ji1109-shuai/fpgashare/README.md

# FPGA 零件智能视觉定额备料系统

基于安路 PH1P35 FPGA 与 SC500CS 摄像头的工业零件视觉识别和输送控制原型，集成图像采集、成像调节、多目标识别、分类计数、批次配额、输送控制及屏幕交互。

本目录整理自当前整机工程。历史文档中的参数、路径与旧版功能以当前源码及下列最新说明为准。

## 主要功能

- 1280×720 图像采集处理与 HDMI 显示，DDR 帧缓存。
- 自动曝光优先调整曝光时间，配合增益边界补偿；默认亮度目标152±8，连续16个有效测光包达标后锁定，目标可调。
- 自动筛选候选中性像素进行白平衡；样本不足时保持最近有效补偿。
- 原图、灰度、Sobel、边缘、二值及形态学预览；工业增强支持细节强度、噪声门限及原图/增强对照，模式7为ENHN。
- 螺丝、垫圈、六角螺母、四方螺母多目标识别及颜色/形状标签。
- 跨检测批次身份关联与方向越线计数；分类配额完成停机、错料/超额保护、普通异常清除确认与故障ACK。
- 10 kHz PWM输送控制，低/中/高档占空比分别为65%/80%/100%。
- NG状态蜂鸣提示，菜单参数配置，完整输出帧率FPS和识别批次耗时DET显示。

显示增强独立于识别输入。FPS不是HDMI刷新率，DET不是摄像头到屏幕的端到端延迟。照片或单次显示值不能作为长期准确率统计。

## 目录

- td_project/：TD工程入口及项目时序约束。
- user_source/：HDL、IP配置与生成HDL、约束、字体及图标ROM。
- sim/：维护中的功能测试、运行脚本和必要测试输入。
- tools/：构建、交付和核验工具。
- mechanical/：本工程中的参数化机械设计及模型。
- docs/：功能说明、操作记录与历史设计资料。
- HANDOFF.md：工程交接及验证边界。

## 开发环境与入口

- 工程文件：td_project/camera_to_dsi_display.al
- 工具记录：Anlogic TD 6.2.168116
- 器件：PH1P35MDG324，速度等级-3
- 摄像头：SC500CS
- 电机驱动：L298N

保持td_project与user_source同级。工程文件保留原始内容，Project Path仍记录开发电脑的路径；换机时应在TD中确认解压目录并另存工程。部分工具脚本使用本机安装路径，运行前按实际环境调整。

logo_idx.hex、logo_pal.hex、industrial_font16.hex是必要ROM资产。手动建立综合/实现Run时须将其复制至相应运行目录；tools/build_ae_once.ps1保留原资源复制逻辑。

## 操作与验证资料

- [整机功能与控制规则](docs/INDUSTRIAL_UPGRADE_20261102.md)
- [视觉增强与原图对照](docs/VISUAL_ENHANCE_20261102.md)
- [界面叠加调整](docs/UI_OVERLAY_20261102.md)
- [电机档位、恢复与帧率](docs/MOTOR_FPS_20261102.md)
- [异常蜂鸣联动](docs/BATCH_BUZZER_20261103.md)
- [仿真入口与覆盖边界](sim/README.md)

仿真、物理时序分析和上板运行分别验证不同层面。构建报告不能替代现场验证；普通照明宽阴影等历史限制见对应文档。本次GitHub整理只核对文件与工程依赖，未重新生成bit。

## 第三方代码与许可

本工程包含厂商示例、生成IP及加密HDL，保留原版权声明。当前未为整个混合工程指定统一开源许可证，也未对第三方资料授予新的许可。相关范围见[第三方说明](THIRD_PARTY_NOTICES.md)。

## 提交内容

包含当前源码、必要资源、维护中的测试与工具、机械设计及文字资料。未纳入本机TD Runs、历史交付归档、波形、编译缓存和日志；旧分支中已有历史资料保留在其原有位置。
