ji1109-shuai/fpgashare/docs/AE_ONCE_AND_MOTION_20261101.md

# 自动曝光收敛锁定与传送带速度分析（2026-11-01）

> 历史版本：下述曝光操作与旧bit保留用于追溯。用户反馈仍需手调后，已确认默认MAN、运动/目标门控、中心测光和I2C应答存在缺陷。当前源码及本轮交付请看 [开机曝光完整闭环修正](AE_CHAIN_BOOT_20261101.md)。本文速度限制分析仍适用，旧18项测试不能代替新闭环测试。

## 修改范围

本次用户指定的工程是 `D:/fpgashare/fpgashare (4)/fpgashare`，TD 入口为该目录的 `td_project/camera_to_dsi_display.al`。不是根工程，也不是 `fpgashare (3)`。

生产修改仅有 `uiisp_beta/ae_set.v`、`design_top_wrapper.v`、`hdmi_mixer.v`：增加一次性曝光收敛锁定、独立的电机暂停条件、菜单实际状态显示。原识别算法、自动白平衡、安路图标、确认框/标签、Sobel/EDGE、DDR 数据路径及引脚/时序约束保持原逻辑。

## 实际操作

1. 保持传送带停止，先让画面中心 64×64 区域露出正常背景，打开菜单选择 `AE:AUTO`。
2. 沿用原始绿色通道均值和 176～216 的宽死区。偏亮或偏暗连续四个有效观测包方向一致时才调整一次；每次 I2C 写入完成后先丢弃两个观测包，等待曝光生效。
3. 无已发布目标、相机配置完成、无待写参数时，连续八个观测包落在死区内才锁定，菜单显示 `AE:LOCK`。锁定后亮度变化、目标进入或传送带启停都不会再自动修改 EXP/GAIN。
4. 需要适应新的照明时，选择一次 `AE:MAN`，再切回 `AE:AUTO`，显式开始下一次调整。系统复位也清除锁定。手动修改菜单 EXP/GAIN 时沿用原逻辑转为 MAN。
5. 未收敛就启动传送带时显示 `AE:HOLD`，暂停自动调节；停带后可继续未完成的收敛。已经 LOCK 的会话停带后仍为 LOCK。

上电仍为原来的 MAN；不会擅自开始自动曝光。无法达到目标区间、达到 EXP/GAIN 上下限或亮度无效时不宣称 LOCK，不进行重复的相同参数 I2C 写入。亮度小于16仍沿用原逻辑不自动追亮，以免失效/遮挡数据驱动补偿。

这里的亮度是 `awb.v` 诊断包 `[119:112]` 的 AWB 前中心区域绿色均值，不是全图测光、物体测光或新的亮度算法。EXP 是该传感器现有控制码，不能直接当成微秒。自动白平衡没有随 AE 一起冻结；当前灯光/背板的颜色验证结论也不因本次修改而扩大。

## 为什么速度提高后会更难识别

源码与定向功能测试确认了一处明确限制：`img_parts_multi_tracker` 只在相邻**识别批次**的同类目标满足 `dx<=64 && dy<=64`、宽高变化各不超过32像素时继承确认历史；需三次关联观测才输出确认框。`tb_tracker_speed_boundary` 证明64像素/批次仍能确认，65像素/批次连续运动会反复从第一次确认开始。这里不是64像素/摄像头帧，不能在未知批次发布间隔、视野尺寸和实际带速时换算成毫米/秒。

同时，`img_tire.take` 在上一批尚未分析完成时会跳过新的帧头；现有 HDMI 插值只是让框移动平滑，不会提高前端识别频率，也不是速度预测跟踪。

## 帧差的作用与建议

帧差可以作为运动候选/活动区域证据，但不宜单独替换现有形状和颜色识别：对于相邻两帧在相同位置的像素，绝对差检测的是变化。停止或慢移物体的重合部分可能没有差分，移动织纹、阴影、曝光变化也可能产生差分。背景模型差分与相邻帧差分是不同方法；本工程已有的空带参考逻辑也不能直接称为已实现运动帧差。

建议后续结合现有 8×8 粗网格做低资源运动统计，以运动方向/估计速度辅助现有一对一目标关联，再根据稳定 ID 做越线计数；同时量测接受帧间隔、发布间隔和拖影。若要提高吞吐量，还要单独优化形态学/连通域分析和候选扫描。不能通过扩大一个位移门限或减少确认次数就宣称高速检测已可靠，也不能靠帧差恢复曝光造成的运动模糊。

本轮仅完成曝光锁定与速度限制的可复现分析，**未把帧差、速度预测或新的计数逻辑接入生产识别**；没有从另一个工程覆盖迁入算法。

参考资料：OpenCV 官方 `How to Use Background Subtraction Methods`（https://docs.opencv.org/4.x/d1/dc5/tutorial_background_subtraction.html）区分静态相机前景掩膜与背景模型更新；Basler 官方 `Exposure Auto`（https://docs.baslerweb.com/exposure-auto）中的 Once/Continuous 说明可用于理解一次性调节与连续调节的区别，不代表本工程传感器型号或控制寄存器相同。

## 验证与交付

运行新增功能测试：

```powershell
& ./sim/run_ae_once_regression.ps1
```

包括默认与边界参数 AE、I2C 忙期间保持/生效等待、锁定保持/重新触发、手动优先、上下限、无效亮度、两种显示读延迟下 MAN/AUTO/LOCK/HOLD 菜单，以及当前识别器64/65像素关联边界。测试输出位于 `sim/ae_once_20261101_validation`，前次生产源码备份保存在其 `before` 子目录。

既有测试夹具同时进行了必要校正：`tb_screen_menu` 原先假定上电 AUTO，但修改前的 v3 生产代码已经默认 MAN；现按真实默认值验证 MAN→AUTO→MAN→AUTO 和手动编辑退出 AUTO。旧 `tb_batch_counter` 把“短按”设为7周期、长按门限却只有6周期，且在采样上升沿改变输入；现将短/长按分开为7/20周期、门限12周期，并在下降沿驱动、等待同步与消抖完成。生产 `screen_menu_control`、`conveyor_batch_counter`、`l298n_motor_control` 三个模块与本轮开始前逐字一致，没有为测试修改其行为。

历史整组 `tb_parts_multi_no_calibration` 在普通照明/宽软影阶段仍失败（frame22：期望4框，实际0框，候选4）；其依赖的 `img_proj.v` 等识别源码本轮哈希未变。失败日志原样保留在 `sim/ae_once_parts_20261101_validation`。新增 `BACKLIT_ONLY` 仅为测试参数，保留原测试默认行为，另以 `tb_parts_multi_backlit` 和 `tb_parts_multi_backlit_latency` 完整覆盖当前背光场景的四目标、颜色变换、确认、删除换序、溢出、空带/无背板及延迟；不把旧普通照明失败描述为已经修复。

整机重建使用 `tools/build_ae_once.ps1`：从本工程 `.al` 读取源码清单，在新的独立 synthesis/physical 目录运行，记录全部输入哈希，不覆盖已有 bit。

本轮18项定向测试顶层通过（详细逐项结果见 `sim/ae_once_20261101_validation/verification.json`），不包括上述保留失败的历史普通照明整组用例。除新增7项曝光/菜单/关联边界测试外，覆盖 HSV、形状流水线、背光多目标与延迟、动态框、8种完整720p显示模式、Sobel/EDGE各3帧DDR连续性、真实自动白平衡及720p ISP。

TD 于2026-11-01 19:55完成物理与bit生成：

- 原始run：`td_project/camera_to_dsi_display_Runs/phy_ae_once_20261101_193113`。
- 交付bit：`release_archive/ae_once_lock_20261101/camera_to_dsi_display_ae_once_lock.bit`。
- 大小：1,789,539字节。
- SHA256：`E9F5B9AB973342E3CF95AEF5D7488A46CBC7073CE887FC63721373AC2360FD56`。
- Setup WNS `+0.111ns`、Hold WNS `+0.020ns`，Setup/Hold TNS及违例端点均0；STA覆盖94.76%，现有告警和时钟例外保留。
- 最终Slice 19483/21216、LUT6 19008/21216、ERAM 76/108、DSP 20/40；Routing DRC完成且无错误。
- 62项TD输入哈希均与当前源码一致，独立run源清单与当前 `.al` 完全匹配；识别、白平衡、视频模式、SDC及引脚约束6项保护哈希未变。
- 构建记录：`td_project/camera_to_dsi_display_Runs/ae_once_build_20261101_193113.json`。交付目录同时保留时序、资源、时钟例外和完整验证记录。未提交或推送Git。

功能仿真、TD 物理时序与上板实测是三个不同层次；目前没有本次新版的上板结论，不能声称实际可用带速已提高或现场颜色已通过。
