ji1109-shuai/fpgashare/docs/MOTOR_FPS_20261102.md

# 电机自动恢复、三档PWM与实时FPS

唯一工程：`D:/fpgashare/fpgashare (4)/fpgashare`，入口 `td_project/camera_to_dsi_display.al`。本轮只改 `design_top_wrapper.v` 和 `hdmi_mixer.v` 两份生产文件；先前的曝光、白平衡、工业增强、透明UI和安路图标保留。

## 操作与恢复条件

- SW4打开菜单，K1/K2选中MOTOR，K3减档、K4加档；STOP、LOW65%、MID80%、HI100%循环。PWM仍为10kHz，IN1输出PWM，IN2固定低；100%为持续高电平。百分比表示占空比，不等同于实测传送带线速度。
- 普通错件或超额停车时保留用户档位。错误类别连续三次新的完整检测发布均未再出现，才解除NG并按保留档位恢复。没有新检测、一次或两次漏检都不能恢复；该类尚未确认但仍被观测到时也视为在场。其他正确类别可以仍在视野内。
- 配额为0的已确认类别在上游被发现就停车，不必等它过计数线。
- 暂停期间手动选择STOP会取消自动启动；批次DONE和NEW BATCH清场会清除速度，之后保持STOP。
- 检测溢出、身份歧义、重复slot、未知类别、首次从下游出现及计数饱和等故障仍要求ACK；至少三次清除观测且检测fault解除后才能确认。普通错件不需要ACK。
- 移走超额件后，仅将本批接受数量修剪到配额，PASS累计通过数量保留，便于审计。达到全部配额后仍保持完成停车。

## FPS含义与显示

左上角批次状态下一行新增FPS，16×16字体、20像素行距、透明背景、亮暗自适应字色。上电首个统计窗口前显示`---`，随后每秒更新整数帧率，例如`030`。

统计点位于ISP输出、video_in之前。每个1280×720 RGB图像由172800个128位有效字组成，只有收到SOF并累积完整帧字数才产生一次完成事件；以50MHz系统时钟统计一秒窗口。跨域只同步完成翻转事件和每秒保持的BCD数值，HDMI在自身SOF锁存，避免一帧内文字撕裂。无新完整图像的一秒窗口显示000。该数值是ISP完整输出帧率，并不表示检测更新率或DDR实际呈现帧率。

## 功能验证与证据边界

当前17项定向顶层回归通过，见`sim/motor_resume_20261102_validation/verification.json`。覆盖实际STOP/65/80/100周期测量、三档错件移除恢复、三次完整发布、掉检/重新出现、手动STOP、硬故障ACK、DONE与超额审计；450个完整帧、非完整帧不计、异步时钟、十进制进位、统计窗口边界和停摄归零；FPS的SOF更新与中途保持。

UI两种DDR读延迟各十个720p画面，每种检查704个菜单字符、47188个HUD字形像素、605612个透明像素；包含三档/STOP文字与FPS字形。真实ISP打包链路的720p增强和左右对照各三帧，完整数据和DDR末行检查通过，FPS各收到三次完整帧。

旧电机源码被新测试在“50拍而非65拍”处拒绝；旧ACK计数器被新自动恢复断言拒绝，失败日志保留。初始无debug优化仿真出现随内部信号可见性而变化的结果，尚未确定编译器根因；保留失败记录，最终采用`--O0 --debug typical`完成全套，并以开启优化的`--debug typical`再次验证电机恢复和跟踪。未以重复到偶然通过作为唯一证据。

未修改的AE/CSI/ISP/增强算法证据按源码及日志哈希复用；本轮没有重跑完整CSI长时仿真。功能仿真不能证明物理时序或上板结果。更高占空比下的实际速度、识别率、错件移除恢复以及FPS读数仍须上板验证。

## 构建状态

构建`motor_fps_r1_build_20261102_234331.json`于2026-11-03 00:13:15完成。原SDC下Setup +0.102ns、Hold +0.020ns，TNS及违例端点均0，Routing DRC通过，无实现ERROR/FATAL；STA覆盖94.70%。Slice20261/21216、LUT6 19800/21216、ERAM80/108、DSP22/40。

原critical warning集合不变。六条新增文字差异已逐条记录：两条原有端口告警仅源代码行号变化；三条高占用估计变化，最终资源仍容纳；时钟级联告警从2组到3组，对前后路由数据库分别执行analyze_clock -detail，新增列出原HDMI PLL反馈树，未新增RTL生成时钟。原I²C局部时钟、混合负载、SDC项目列表等告警和未覆盖时序限制仍保留，不声称零告警。详情见all_warning_comparison.json和clock_analysis_r2.log。

归档文件`release_archive/motor_fps_20261102/camera_to_dsi_display_motor_fps.bit`，1789539字节，SHA256 `07D459B95457A11C4EA6422F9A455E2A283EF494A9B09699B2580D6910A35E7E`。默认run身份以verification.json的defaultRun及HANDOFF顶部记录为准。原默认run完整备份，未烧板、未提交推送。
