ji1109-shuai/fpgashare/docs/README.md

当前整机视觉增强说明：[VISUAL_ENHANCE_20261102.md](VISUAL_ENHANCE_20261102.md)，限定 `(4)/fpgashare`；完成状态以 HANDOFF 最新节和本轮 verification.json 为准。此前工业升级基线：[INDUSTRIAL_UPGRADE_20261102.md](INDUSTRIAL_UPGRADE_20261102.md)。

# 资料索引与迁移边界

2026-11-01 用户明确要求不能只调GAIN，当前曝光优先版AE4见[AE_EXPOSURE_20261101.md](AE_EXPOSURE_20261101.md)：双向EXP优先、曝光边界才补GAIN，保留可调目标及16包锁定，含实际I2C曝光变化和旧策略负对照。35/35项功能、TD最终时序及默认bit同步已完成，尚未上板；最终哈希与交付状态以该文档及HANDOFF最新节为准。原[AE_TARGET_20261101.md](AE_TARGET_20261101.md)为已废弃、未交付的AE3候选。

2026-11-01 现场反馈“AE为MAN、EXP/GAIN不变化”后的当前追查与修正，见 [AE_FIELD_BOOT_20261101.md](AE_FIELD_BOOT_20261101.md)：启动按键释放门控、真实CSI标记、AE2可见诊断，以及新bit与默认入口一致性核验。最终交付状态以该文档和 `HANDOFF.md` 最新节为准。

2026-11-01 用户反馈仍需手调后的当前曝光行为、实际像素/I2C闭环、RAW/ISP验证及新bit交付，见 [AE_CHAIN_BOOT_20261101.md](AE_CHAIN_BOOT_20261101.md)。前一版 [AE_ONCE_AND_MOTION_20261101.md](AE_ONCE_AND_MOTION_20261101.md) 的曝光行为已被修正，其64/65像素关联限制分析保留。历史普通照明用例仍失败，不能当成当前任意背景均已验证。

2026-10-25 已加入普通白纸、无背光板条件下的阴影抑制与孔洞恢复，设计和仿真边界见 [NORMAL_LIGHT_SHADOW_SEGMENTATION_20261025.md](NORMAL_LIGHT_SHADOW_SEGMENTATION_20261025.md)。

本目录为工程独立协作整理必要资料。当前状态优先查根目录 `HANDOFF.md` 和实际源码；历史文档用于追溯，可能含旧目录名、旧显示时钟或当时未完成事项，不能直接作为当前配置。

2026-10-22 新增右上角识别批次延迟显示，计时范围、实现与上板步骤见 [LATENCY_OSD_20261022.md](LATENCY_OSD_20261022.md)。颜色实物验证暂缓，待下一次继续。

2026-10-19 当前偏绿修正见 [AUTO_WB_20261019.md](AUTO_WB_20261019.md)。固定1倍补偿与反光投票两次实验均已撤回；`COLOR_NO_CALIBRATION_20261019.md` 和 `COLOR_GLARE_VALIDATION.md` 为失败实验记录，不能按它们的步骤使用当前工程。

2026-10-22 黄铜颜色现场诊断显示当前暂时开启，数据解释和采集步骤见 [COLOR_DIAGNOSTICS_20261022.md](COLOR_DIAGNOSTICS_20261022.md)。此诊断版未改变分类规则或自动白平衡。

用户随后确认自动白平衡上板解决偏绿。在此基础上的 HSV 色相分类、黑色反光处理及仅保留 EXP/GAIN 的界面调整，见 [COLOR_HSV_20261019.md](COLOR_HSV_20261019.md)，此轮颜色修改仍待上板核验。

队友开始协作前，先阅读 [Git/GitHub 操作指南](GIT_COLLABORATION.md)，按各自功能分支、PR 检查和合并的流程开发。

## 已迁入的关键内容

| 目录 | 内容 | 用途 |
| --- | --- | --- |
| `history/wb_probe_20261017/` | 最新诊断版说明和历史验证摘要 | 读懂 RAW、R/B、HI/LO/CAST、SMP 和上板采集步骤 |
| `history/wb_invalid_fix_20261017/` | 旧补偿残留问题及修复记录 | 区分无效参考回退与真正色偏校正 |
| `history/cwc_recovery_20261017/` | ChipWatcher recovery 违例定位 | 避免误改识别算法或隐藏时序违例 |
| `history/multi_parts_20261017/` | 多目标版本说明和验证摘要 | 了解检测范围、图标恢复和结果关联 |
| `evidence/cwc_20261017/` | 当次完整异常路径报告、资源报告和时钟摘要 | 保留负裕量路径的可核实证据；不是当前新构建结果 |
| `evidence/wb_probe_20261017/` | 选定旧仿真日志，转为 txt 保存 | 复核当次通过的用例；不代表迁移后全部已重跑 |
| `reference/hardware/` | SC500CS 数据手册、摄像头原理图、开发板手册和10张开发板原理图 | 摄像头配置、增益表、接口与引脚查证 |
| `reference/notes/` | SC500CS/I2C、MIPI、数据流及系统计划笔记 | 解释设计背景；写作时间早于当前版本，需核对源码 |
| `reference/tools/` | TD 官方调试工具指南 SWUG111 | ChipWatcher 的实例禁用、采样与触发配置；此前时序调试所用参考 |

硬件文档按原资料文件名保留，不凭文件名推定与手中板子的版本完全一致；连接、供电或按键判断前，应核对实际板型/版本。笔记中的指令和旧流程不自动成为当前工作要求。

`migration_manifest.json` 记录此次复制文件的源路径、仓库相对目的路径、大小和 SHA256。清单包含旧目录路径用于溯源，正常开发和测试不需要访问这些路径。

## 尚未迁入与保留位置

- 原 Git 提交历史：仍在 `D:/FPGA_competition/.git`；新仓库从源码快照开始。
- 整段聊天记录：仍在 Codex 对话中；HANDOFF.md 是结构化摘要，不是全文导出。
- 所有历史照片和截图：没有逐一迁入，部分位于临时附件目录，不能保证以后仍可读取。关键观察已经记入 HANDOFF.md。
- 所有旧源码快照、完整 TD Runs、仿真数据库、波形和工具安装包：不随工程迁移。
- TD 完整官方手册和全部 FPGA/IP 文档：没有批量复制。后续若某项任务需要尚未迁入的资料，应明确缺少哪个文件，再从用户保留的原资料中补充，不能编造其内容。

后续上板照片建议存为 `docs/field/<日期>/`，同时写清提交号、EXP/GAIN、SW4、WB/REF、灯光和器件摆放。只有用户需要共享的照片才放入 Git。

## 迁移后的访问原则

新 Codex 项目和队友只需要本仓库即可获取已整理的源码、当前状态、关键硬件资料与三组测试。不要假设项目移动后会自动继承旧目录权限；更换对话时优先阅读 HANDOFF.md。

本次整理没有修改生产 RTL，没有运行 TD 构建，也没有自动提交或推送。新增文件上传前可以在 GitHub Desktop 中审阅。

- [电机自动恢复、三档PWM与FPS（2026-11-03）](MOTOR_FPS_20261102.md)：当前(4)整机交付、恢复条件和统计口径。
- [批次错误蜂鸣提示（2026-11-03）](BATCH_BUZZER_20261103.md)：NG短鸣、自动解除与ACK联动，保留原整机功能。
