ji1109-shuai/fpgashare/docs/AE_CHAIN_BOOT_20261101.md

# 开机自动曝光闭环修正（2026-11-01）

> 历史独立构建记录。后续现场仍为MAN，已发现默认run未同步、启动按键误接管和此前测试绕过的前端截帧问题。新修正见`AE_FIELD_BOOT_20261101.md`，不能沿用本页26项结果作为新修复已通过的依据。

## 工程与问题

本次修改仅针对 `D:/fpgashare/fpgashare (4)/fpgashare`，入口是该副本的 `td_project/camera_to_dsi_display.al`。用户反馈前一版仍需手调后，重新核对了像素来源、默认开关、自动调节条件、传感器编码、I2C 应答和图像生效延迟。

前一版 `ae_once_lock_20261101` 有实际设计缺陷，不能作为本轮交付：

- 上电仍为 MAN，自动曝光没有默认运行；非零电机档位、已确认目标和小于16的亮度还会阻断自动调节。
- AE 使用 AWB 诊断包里的中心64×64原始绿色均值，中心有暗零件时不适合作为背景曝光依据，也没有独立的完整帧有效标志。
- 近目标时固定32曝光码的步长对短曝光过大，可能在目标两侧反复调整。
- 相机配置器忽略 I2C NACK，完成标志不能证明每个寄存器获得应答。这是源码审计发现的问题，尚无证据说它就是现场失败的唯一原因。
- 原AE测试注入亮度并模拟配置完成，没有覆盖开机默认菜单、真实图像测光和实际总线写入的闭环；不能据此证明开机自动曝光可用。

## 现在的完整链路

`CSI RAW10 → 原生产去马赛克 → AWB前RGB → 独立测光 → 跨域发布 → ae_set → 增益ROM → 曝光寄存器序列 → 真实uii2c → 摄像头`。

新增测光器在 `isp/isp_top.v` 内并联观察，RGB、有效信号、帧头、行尾、AWB和DDR路径没有插入新延迟。canonical RGB包首像素为最高24位；亮度为 `(R+2G+B)/4`。除去四边各1/16，每8×8格抽样一个像素，用16档直方图的75百分位作为背景亮度。这样小块中心暗零件不会独占测光；它仍是空间亮度统计，不是语义背景分割，不保证背景占比很小、强反光或任意光照下都合适。

测光独立检查完整1280×720帧、320拍每行、正确行尾及样本数。黑帧和饱和帧都是有效测量；半帧、异常行尾和不完整数据不能用于调整或证明收敛。支持上游多拍提前帧头。

相机配置器现在逐寄存器锁存总线错误，发生NACK时重写当前寄存器，只有获得应答才前进。摄像头持续不应答时保持配置未完成，AE不能伪报完成或LOCK；未增加新的硬件故障显示或寄存器读回，ACK也不等同于实物光学效果已确认。

传感器依据为工程内 `docs/reference/hardware/SC500CS_数据手册_V1.8.pdf`：第22页调节顺序、第23页曝光与增益寄存器/生效时序、第24～25页模拟增益表。写入第N帧，参数在N+2帧生效。曝光以半行为单位，最小码3；当前表VTS=0x0467=1127，最大码 `2*1127-10=2244`。不是微秒。3e03低四位为0xb，模拟增益写入3e08/3e09。

## 操作和控制行为

1. 复位后直接 AUTO，不需要先按键或手动调 EXP/GAIN。电机档位及识别结果不再决定是否允许曝光收敛。
2. 连续4个完整有效观测在176～216目标区间同一侧，才产生一次调整；远暗时曝光每次最多增加约50%，避免“翻倍饱和→减半偏暗”的往返振荡；近处曝光步长为当前曝光约1/16且不超过32码，最少1码。
3. 每次实际I2C参数写完后丢弃2个完整测光包，再判断新的亮度；连续8包在区间内则菜单显示 `AE:LOCK`。
4. LOCK后即停止自动修改EXP/GAIN，亮度变化、物体经过和传送带启停都不会重新调节。
5. 需要重新适应灯光时，在菜单AE行选择MAN，再切回AUTO；复位也会重新启动。菜单EXP/GAIN编辑，或菜单外显式按相机KEY1/KEY2，都会接管为MAN。

到达曝光/增益边界仍达不到目标时保持AUTO，不宣称LOCK，也不重复写相同参数。自动白平衡继续按自身规则运行；AE锁定不同时冻结白平衡。

## 功能验证

```powershell
# 测光单元；真实寄存器、I2C应答、异步配置时钟及N+2图像反馈闭环
& ./sim/run_ae_chain_regression.ps1 -BuildName ae_chain_release_final_20261101_validation
# 真实RAW10、生产去马赛克、完整720p ISP测光与输出完整性
& ./sim/run_ae_raw_isp.ps1
# 同一次连续运行中串起完整720p RAW/ISP、AE、实际I2C和N+2传感器反馈
& ./sim/run_ae_raw_isp.ps1 -BuildName ae_chain_full_system_20261101_validation -Tops tb_ae_full_system
# 控制器边界、无效包、手动接管、菜单双读延迟和既有速度边界
& ./sim/run_ae_once_regression.ps1 -BuildName ae_chain_units_20261101_validation
```

闭环模型从实际I2C引脚逐位解码得到曝光/增益，再按N+2延迟产生图像。8个顶层覆盖测光、开机过亮、真实暗亮度小于16、最小增益下的中等照明振荡反例、强照明下短曝光、中心黑零件、电机已运行、初始化NACK重试、运行时NACK重试，以及锁定后光照改变仍不写参数。不存在注入测光均值或伪造cfg_done的反馈捷径。光学响应是合成模型，不是实物传感器模型的完整标定。

使用修前配置器作为反例时，同一NACK测试在初始化跳过未应答寄存器处明确失败；修后逐寄存器应答计数全部通过，避免测试只是自洽地报告成功。

RAW/ISP测试使用生产RAW10解包、行拼接、双线缓存、BGGR插值、AWB和ISP；仅厂商RAM以行为模型替代。4帧720p核对3个完整测光结果和691200个打包输出。另对自动AWB、8种720p显示、Sobel/EDGE与DDR帧尾连续性、背光多目标与延迟做定向回归。测试结果由 `sim/ae_chain_20261101_validation/verification.json` 汇总。

最终26个定向功能顶层全部通过。完整 `tb_ae_full_system` 在一次连续仿真中串起720p RAW→实际生产ISP→AE→实际I2C→N+2图像反馈；全程没有按键，初始过曝最终收敛至EXP=2244/GAIN=48，5组应答完整的曝光寄存器序列（含初始化），总共47帧，其中锁定后改变光照再检查12帧，未再产生自动参数写入。这些码值和帧数是该合成光照用例的结果，不是现场推荐手调值或实物收敛时间。

旧普通照明宽软影多目标用例的历史失败保留，识别源码未在本轮修改；不宣称阴影识别、现场颜色或最高带速已改善。当前64/65像素每识别批次的关联限制及帧差分析见旧版说明的“速度”部分，本轮没有接入新帧差、速度预测或计数器。

## 构建与实测边界

本轮最终独立TD构建：`ae_chain_boot_r1_build_20261101_202117.json`，2026-11-01 20:21:18开始，20:52:03完成。新的syn/phy目录不覆盖旧bit；最终构建开始后生产RTL保持不变。此前20:17开始的试构建在发现快速步长振荡后已停止，目录和失败记录保留，不作为交付。

| 最终检查 | 本次结果 |
| --- | --- |
| Setup WNS / TNS / 违例端点 | +0.102 ns / 0 / 0 |
| Hold WNS / TNS / 违例端点 | +0.020 ns / 0 / 0 |
| STA覆盖率 | 94.76%（当前原SDC） |
| Slice / LUT6 | 19879/21216 / 19503/21216 |
| ERAM / DSP | 76/108 / 20/40 |
| Routing DRC | 完成，无实现ERROR/FATAL |
| 工程输入 | 62项哈希与构建启动时一致，有效源清单一致 |
| 功能验证 | 26/26通过，修前配置器NACK负对照按预期失败 |

交付文件：`release_archive/ae_chain_boot_20261101/camera_to_dsi_display_ae_chain_boot.bit`，1,789,539字节。

SHA256：`CB1BB42993BD0786A849E7D6BAE8D1DE35880040012EA5E85E18150DB4E752EB`。

已复核原run与交付副本哈希一致，并归档最终时序、资源、例外、route_flow、构建输入和verification记录。原run为 `td_project/camera_to_dsi_display_Runs/phy_ae_chain_boot_r1_20261101_202117`；旧 `ae_once_lock_20261101` 的bit不是本次交付。

TD保留原有调试总线、`scl_clk`/相机时钟mixed-fanout及PLL输出未定位等告警，没有用新增false path或修改SDC来隐藏。运行目录的`.prj`仍含仅文件名的SDC元数据，产生`PRJ-7001`；实际执行的`settings.cfg`中`SDCList`指向本工程原`camera_to_dsi_display.sdc`。验证工具分别核对有效源清单、SDC哈希及最终STA报告的Constraint File，不能把该元数据告警描述为不存在，也不能把时序覆盖率描述为100%。

功能仿真与当前约束下TD物理检查已完成；**尚未下载到板子，现场是否无需手调仍未实测**。本次没有提交或推送Git，也没有修改识别、帧差、AWB或电机/计数逻辑。
