ji1109-shuai/fpgashare/docs/AE_EXPOSURE_20261101.md

# AE4：曝光优先与可调收敛亮度（2026-11-01）

## 当前状态

35/35项定向功能回归和独立TD综合/布局布线/bitgen全部完成，默认`syn_1/phy_1`已于2026-11-01T23:11:52.1363606+08:00同步并核验。归档bit为`release_archive/ae_exposure_20261101/camera_to_dsi_display_ae_exposure.bit`，1,789,539字节，SHA256 `9E83A5F8B26B977F482D88628103E56DA452D2443FF436E4D9582B31309BB869`。这是AE4曝光优先版，AE3未交付。尚未上板、未提交推送。

## 现场反馈与根因

用户指出“不要不动曝光只动增益”。逐行核对控制器后确认：上一候选AE3在过亮时先降低GAIN，只有GAIN降到下限才降低EXP；所用场景会在GAIN调整阶段收敛，造成EXP始终2244。此前测试只核验输出与I2C寄存器一致，没有要求运行时EXP实际改变，因此不足以覆盖用户要求。没有采用此前无证据的“780”结论。

## 调整规则

- 过亮：优先降低EXP，只有EXP已到3时才降低GAIN。
- 过暗：优先增加EXP，只有EXP已到2244时才增加GAIN。
- 每次只动一个执行量；完成真实I2C序列后等待N+2完整观测包，再重新判断；远暗按最多1.5倍加曝光，近目标细调。
- 默认目标128，允许112～144；连续16个完整有效测光包达标才LOCK，锁定后停止自动调节。无效包、配置忙和空等时钟不能累计稳定次数；上下限仍不达标时不能假LOCK。
- SW4开菜单，KEY1/KEY2选择末项`AE Y`，KEY3减/KEY4加。目标64～192、步长8、允许范围为目标±16。AUTO/LOCK中改目标自动重新收敛；显式MAN保留。复位恢复128，不做断电保存。
- 屏幕版本`AE4`，`T`和菜单目标是十进制，`Y`测光是十六进制。目标允许范围有重叠，调一档后若仍达标只重新确认，不强行改变曝光。

## 验证设计

- 总线上独立解码`0x3E00/01/02`曝光及`0x3E08/09`增益，排除初始化写入，统计实际EXP/GAIN变化。
- 每个自动序列检查：不能同时改变EXP和GAIN；只有EXP=3才允许减GAIN、EXP=2244才允许增GAIN。普通场景必须至少一次实际EXP变化。
- 明场、短曝光暗启动、运动、NACK、目标64/192及锁后重设均保留；新增极亮到EXP下限后降GAIN、极暗在EXP上限增GAIN。
- AE3原控制器负对照在实际总线EXP=2244/GAIN=96时被新断言正确拒绝，证明新增测试确实能发现“只动GAIN”的旧策略。
- 完整1280×720 CSI用合成光照LIGHT=32，从裁剪亮场触发真实EXP调整，走CSI/RAW10、流转换、校正、ISP、测光、控制器、实际I2C解码及N+2反馈；长消隐600/856/1112拍交替，每帧原始/校正均230400拍。完整场景作为集成检查，较长调节路径由快速同链路场景覆盖，未替换生产控制参数。
- 其余保留AWB、EDGE/Sobel/DDR连续性、零件及计数回归，验证工具`tools/verification/verify_ae_exp.py`；旧AE3构建标记为`superseded_unreleased`，不交付。

## 已取得的快速闭环证据

|场景|锁定EXP|锁定GAIN|实际EXP变化数|实际GAIN变化数|
|---|---:|---:|---:|---:|
|普通亮场，LIGHT=100|315|112|5|0|
|极亮场，LIGHT=40000|3|56|10|5|
|暗场且EXP已到上限，LIGHT=10|2244|128|0|4|

这些数值来自独立I2C总线解码后的合成光照功能仿真，不是现场曝光推荐值。极亮场先完成2244→…→3的曝光调整，随后才将GAIN112→96→80→64→60→56；暗场保持上限EXP并增加GAIN。各场景达标锁定后均再改光照并保持12帧无新增写入。

## 最终构建与交付

- 工程入口：`D:/fpgashare/fpgashare (4)/fpgashare/td_project/camera_to_dsi_display.al`；顶层EXP/GAIN/REQ已核对直连生产运行时I2C配置器。
- 构建记录：`td_project/camera_to_dsi_display_Runs/ae_exp_r1_build_20261101_223900.json`；2026-11-01T22:39:00.8669284+08:00～2026-11-01T23:11:29.3000102+08:00。
- 原SDC下Setup WNS **+0.105ns**、Hold WNS **+0.020ns**；TNS及违例端点均0，Routing DRC完成，无实现ERROR/FATAL；STA覆盖率94.78%，既有告警及约束例外保留。
- Slice 19996/21216，LUT6 19491/21216，ERAM 76/108，DSP 20/40；62项工程输入及实际源清单一致。相较最近AE2仅ae_set、顶层及hdmi_mixer三文件累计改变。
- 默认bit：`td_project/camera_to_dsi_display_Runs/phy_1/camera_to_dsi_display.bit`；归档bit、独立run及默认bit三处SHA256相同：`9E83A5F8B26B977F482D88628103E56DA452D2443FF436E4D9582B31309BB869`。
- 默认综合数据库及最终报告核验一致，phy_1父run为syn_1；旧默认目录保留为`syn_1_before_ae_exp_20261101_231151`和`phy_1_before_ae_exp_20261101_231151`，旧bit SHA256 `B9FD637836B9181146C22AA0193AB575DBAC9F990BD353170956EC6F684A0CBE`。
- 完整CSI闭环37帧，第25帧测光136锁定，实际EXP2244→1122，GAIN112保持。连续16有效观测后才LOCK；锁后降为1/8合成光照，测光降到24，再12帧无新增写入；每帧原始/校正均230400拍。
- 验证记录：`sim/ae_exp_20261101_validation/verification.json`，状态`verified_no_board_test`、`defaultRun.verified=true`、`issues=[]`。源快照、源码哈希及负对照记录随归档保存。

## 验证边界

这里只能验证功能和原SDC下的物理实现；相机光学响应及厂商RAM使用仿真模型，I2C ACK解码不等于上板寄存器读回。未上板、未提交推送；不能声称实际光照、颜色或最高带速已经通过。
