ji1109-shuai/fpgashare/docs/AE_TARGET_20261101.md

# 历史候选：自动曝光亮度目标可调（AE3，未交付）

**此候选已被AE4取代，不可烧录为本轮交付。** 用户指出其亮场仍优先降GAIN、EXP不变；改为曝光优先后的当前状态见[AE_EXPOSURE_20261101.md](AE_EXPOSURE_20261101.md)。下列AE3物理结果只保留追溯，构建标为`superseded_unreleased`。

工程：`D:/fpgashare/fpgashare (4)/fpgashare`，入口`td_project/camera_to_dsi_display.al`。

## 最新现场反馈与本轮范围

用户确认当前问题是“收敛太快、画面明显过亮”，希望降低可收敛亮度，或将其做成可调。
因此本轮调整测光目标及锁定确认，并保留上一轮已修好的启动按键、完整CSI标记、真实I2C完成握手和N+2等待。
前一版176～216内连续8次达标的合同已经被本轮替代，不能继续按旧目标评价新版。

本轮只改`ae_set.v`、`design_top_wrapper.v`和`hdmi_mixer.v`三个生产文件。
AWB、检测/分类、帧差/运动预测、电机、批次计数、像素数据延迟、CSI校正、DDR、SDC及引脚不改。

## 新目标与锁定规则

- 默认亮度中心从旧区间中心196降为**128**，默认允许范围**112～144**。
- `AE Y`可在**64～192**间调整，**步长8**；允许范围始终为所选目标±16。
- 连续**16个完整有效测光包**达标才LOCK；空等时钟、无效包、未完成配置及I2C忙时不能充数。
- 实际I2C完成后仍丢弃2个有效测光包，等待N+2。连续4包在同一侧超范围才调整参数。
- LOCK后停止自动写入。处于AUTO/LOCK时改`AE Y`会清除旧锁定及累计次数，按新目标重新收敛，无需手调EXP/GAIN。
- 显式MAN不会被目标编辑强行改回AUTO；直接编辑EXP/GAIN仍进入MAN。
- 目标是当前AWB前空间75百分位测光值，不是零件表面平均亮度，也不保证任意背景/照明都具有相同视觉效果。

## 操作

1. SW4打开菜单，KEY1/KEY2移动到最后一项`AE Y`（RESET COUNTS之后）。
2. KEY3降低目标，KEY4提高目标；数值越小，目标画面越暗。
3. 菜单关闭后目标保持；复位/断电后恢复默认128，不做非易失保存。
4. 屏幕应显示本轮版本`AE3:AUTO`，达标后为`AE3:LOCK`及`S:16/16`。

调整步长8小于稳定容差的总宽度32。如果只调一档，而当前测光仍在新目标±16范围内，控制器会重新完成16次确认，但不强制改变曝光；若画面仍亮，可继续降低目标，例如由128调到112或96。这样保留稳定区，避免为了单档差异反复抖动。

左侧三行示例：

```text
AE3:AUTO Y:88 V1
I:11 W:05
T:128 S:07/16
```

`T`和菜单目标为十进制；`Y`为十六进制实测值，默认允许区间112～144对应`70～90`。
`I`为初始化/配置完成，`W`为完成的运行时写入数（十六进制）；ACK及完成信号不等于传感器寄存器读回。
保留图标、确认目标框与标签、批次计数和其他菜单功能；菜单仅增加一行。

## 验证和构建

- 新控制测试覆盖默认低目标、16次门槛、无效包打断、空等不计数、上下限及步长、LOCK后改目标自动重启、显式MAN保持。
- OSD在两种读延迟下逐字符覆盖全部17个目标值，以及AE3、I/W、S:16/16和菜单新行。
- 实际I2C闭环覆盖默认值、64/192边界、LOCK后从128改为64、NACK/重试、暗亮边界及运动状态。
- 真实CSI/RAW10→生产校正→720p ISP→测光→AE→实际I2C解码→N+2合成图像反馈重跑；每帧检查230400拍完整传递。
- AWB、Sobel/EDGE与DDR连续性、多目标/延迟、菜单和计数回归重跑。

构建记录`td_project/camera_to_dsi_display_Runs/ae_target_r1_build_20261101_215900.json`。
TD已于2026-11-01 21:59:00～22:21:31完成。原SDC下最终Setup +0.101ns、Hold +0.020ns，TNS及违例端点均0；Routing DRC完成，无实现ERROR/FATAL，原有告警及约束例外保留。Slice19903/21216、LUT6 19489/21216、ERAM76/108、DSP20/40，STA覆盖94.77%；62项输入哈希和实际源清单均一致。

当前32/33项定向功能验证通过，仅完整CSI闭环尚在运行；默认`phy_1`仍为上一版AE2，最终全部通过后才备份并同步。
新原始run bit的SHA256为`D4173A7F103C04DAEB97F3EE65B834B6806C1B43E3D86DB9B9D4549CC2CCF37D`，尚未按默认路径交付。
证据为`sim/ae_target_20261101_validation/verification.json`。尚未上板，不能以合成光学仿真声称现场亮度或颜色已经合适。
