ji1109-shuai/fpgashare/docs/INDUSTRIAL_UPGRADE_20261102.md

# 工业视觉与计数升级（2026-11-02）

本轮仅修改用户指定的 `D:/fpgashare/fpgashare (4)/fpgashare`。工程入口为
`td_project/camera_to_dsi_display.al`，不是根工程或 `(3)` 的 bit。
最终构建、SHA256、物理时序及验证统计以本文件末尾的交付记录和
`sim/industrial_upgrade_20261102_validation/verification.json` 为准。

## 自动曝光

- 默认 AE Y **152**，允许 **144～160（±8）**。连续 **16 个完整有效测光包**达标才 LOCK。
- 上电 AUTO；先调曝光 EXP，普通场景不会只调 GAIN。曝光到上下限才用增益补偿。
- 极强光下 EXP≤8、相邻整数曝光档来回跨过目标区间时，允许增益单档微调，解决量化振荡；没有扩大 ±8 容差。
- I2C 完成后继续丢弃 N+2 生效等待期间的测光，NACK 重试和手动接管保留。
- LOCK 后停止自动写曝光/增益。照明明显变化时，在菜单切 MAN→AUTO，或在 AUTO/LOCK 中改变 AE Y 重新收敛。
- 菜单 AE Y 范围64～192，步长8。显式 MAN 下改目标不会抢回自动控制。
- EXP≈1100、GAIN112 是用户的现场参考，不硬锁为这两个数；实际通过测光闭环达到目标亮度。
- 152 对应所选照片的显示 AEY。测光是场景统计值，换背景、目标占比或照明后不等于整张画面/每件零件都保持相同亮度。

## 工业细节增强（ENHN）

删除原模式7 CART 卡通量化及黑色轮廓，替换为亮度域 **3×3 Gaussian 基础层＋软门限非锐化增强**。
适合展示金属零件轮廓、孔边和细小纹理。高斯基础层用于提取细节，并非把整幅图直接模糊。

- 同一个亮度增量施加于 RGB 三通道，并用通道共同余量限幅，保留通道差异，避免单通道饱和产生色边。
- 中心亮度≤16或≥240时保护，不增强；增量限制在±24，控制光晕。
- `DETAIL` 为0/1/2/3，对应关闭/0.5/1/1.5倍，默认2。
- `NOISE` 为0～15，默认4；差分幅度小于等于此值不增强。噪点明显时调大，细节太弱时小幅调低。
- 参数在帧首锁存，帧内不切换，保留原 Sobel/EDGE 行缓存、帧尾回放和 DDR 有效节拍。
- 上电默认 ENHN；菜单 VIEW 可切 RGB 作原图对照。DETAIL=0保留增强路径时序，但输出原始RGB。
- **本轮增强只进入显示链**；AWB、AE测光、形状及颜色分类保持原上游图像。不能据显示更清晰声称识别准确率已提高，也不是阴影消除、去反光或缺陷检测。

## 界面

- 全部文字统一16×16等宽字格；固定行距、标签列和数值列，使用深色面板与明确选中行。
- 保留安路Logo；只有已确认的目标才显示框和颜色/形状标签。
- 左侧显示 VIEW、EXP、GAIN、四类 OK/SET 和 PASS，以及 AE5、十进制测光Y、TARGET与稳定计数。
- 右侧菜单两页、共15项。菜单覆盖区内的框/标签被遮挡，避免穿透。
- 菜单关闭后设置继续生效；断电不保存。

## 计数与异常

计数方向固定为**画面从左向右**。每个目标保存槽号及代际身份，四目标一对一匹配；根据真实观测时间间隔估计位移，避免只依赖每次移动≤64像素。

1. 目标中心先到 **x≤624** 的上游区武装；确认后的同一身份中心到 **x≥656** 才计一次。
2. 计数线位于x=640，左右各16像素滞回；反复摆动、目标槽排序变化、同类旧件离开同时新件进入不会按占线数量猜数。
3. 关联保留最多两次漏检，采用实际毫秒间隔预测；形状短暂抖动保留身份，但不显示未经确认的新类别。
4. `OK/SET` 为本批接收数/配额，`PASS` 为本批实际通过数。DONE或NG后仍继续记录惯性进入的零件；不会因停机冻结而漏掉超额件。
5. 超额不会因目标消失自动消除。移除异常类别的零件，连续3次观测无此类别，再选 `ACK NG` 显式确认；接收数最多回到配额，PASS保留。
6. 对漏检/身份异常的ACK意味着操作者已核对实物；系统不凭空补算不可确认的通过数量。
7. `NEW BATCH RESET` 清本批数和PASS，要求视野清空后才允许新一批计数。清零或确认异常后均须显式重新选择电机档位，不会自动重启。
8. 上电停带时已在下游的静物不计数、不误报；运行中才首次出现于计数带/下游、检测容量溢出、重复身份、计数饱和等进入NG，避免猜测一个计数。

固定照明、分离目标、每次最多4件仍是当前工作条件。粘连、完全遮挡、超出关联范围、首次发现时已经越线均不能保证精确计数。不能把合成位移测试换算成已验证的传送带速度。

## 按键

| 操作 | 功能 |
|---|---|
| SW4打开/关闭 | 显示/收起菜单 |
| K1 / K2 | 上一项 / 下一项，跨页自动切换 |
| K3 / K4 | 减 / 加；在RESET或ACK项执行对应动作 |
| VIEW | RGB、GRAY、SOBEL、EDGE、BIN、ERODE、DILAT、ENHN |
| AE Y | 亮度目标，默认152、步长8 |
| DETAIL / NOISE | 增强强度 / 细节软门限 |

## 资源实现

RGB行缓存的普通读和帧尾回放采用RAM前地址复用。形态学临时缓存将数据选择移到同步RAM输出后，并同拍保存选择和另一支数据；保持原算法周期，不新增像素流水级。前者从分布式RAM迁至3个ERAM，后者避免1位缓存占用2048个分布式RAM LUT。通道共同余量与亮度保护在原有高斯寄存级并行预计算，细节限幅后只需6位有符号偏移；移除数学上冗余的二次RGB饱和器，不改变输出像素与周期。最终资源仍以本文件末尾的TD报告为准。

## 验证边界

功能仿真、TD物理实现与上板效果分开记录。厂商RAM、传感器光学响应等部分使用模型；实际I2C寄存器写入由测试解码，但不是传感器寄存器读回。
历史普通照明宽阴影/孔洞识别用例仍须与修改前源码对照，不因本次显示增强宣称解决。新旧UI布局不同，旧坐标/旧字库像素期望不再代表当前合同；新UI使用真实RTL整屏渲染和两种读延迟逐像素核验。
验收按受影响链路重跑：最终增强/菜单/UI/计数使用core_r9，整帧ISP、叠加与DDR使用video_r8；形态学RAM改造后的完整检测使用parts_r7。真实CSI闭环沿用AE/RAW/测光均未再修改的csi_r4编译结果；其后的缓存端口和增强输出等价实现由上述新回归覆盖。AWB和颜色回归沿用未修改算法的colour_r4，不将这些记录说成全部RTL均在同一次仿真运行。

本轮未烧板、未提交或推送Git。

<!-- FINAL_BUILD_RECORD -->

## 最终交付记录（2026-11-02）

- 最终构建：`industrial_r8_build_20261102_012449.json`，开始01:24:49，完成01:48:06（北京时间）。r1～r7均为取消或未交付的中间记录，不能代替本次bit。
- 归档bit：`D:/fpgashare/fpgashare (4)/fpgashare/release_archive/industrial_20261102/camera_to_dsi_display_industrial.bit`，1,789,539字节。
- SHA256：`E88296C5880293844A739C23341C41C6F6C14D80DFD6976533EF0EE9074D55FD`。
- 默认bit：`D:/fpgashare/fpgashare (4)/fpgashare/td_project/camera_to_dsi_display_Runs/phy_1/camera_to_dsi_display.bit`；01:48:58同步` syn_1/phy_1 `，独立实现、归档和默认三处bit一致，数据库/报告、有效源清单和3份ROM均已核验。
- 旧默认备份：`syn_1_before_industrial_20261102_014858`、`phy_1_before_industrial_20261102_014858`。
- 最终Setup WNS **+0.060 ns**、Hold WNS **+0.020 ns**；两类TNS均0，违例端点均0；Routing DRC完成并Check Pass。时序余量仍较小，不代表上板或任意PVT条件已实测。
- 最终Slice **19031/21216**（89.70%）、LUT6 **18404/21216**、ERAM **80/108**、DSP **22/40**；未放宽原SDC，STA覆盖率**94.58%**。
- **51/51**项定向功能顶层通过；**66**项工程输入/资产哈希与最终构建一致；7份既有RTL修改及新增字体ROM，保护的根/其他工程生产源码未变。
- 真实CSI→RAW→ISP/测光→AE→I2C闭环共67帧：第55帧AEY152、EXP1282/GAIN112锁定；之后降光到AEY24仍保持12帧，无新自动写入。6次实际I2C曝光值改变，普通场景GAIN始终112。上述数值为传感器响应模型的功能证据，不是实物相机测量。
- 当前构建无ERROR/FATAL。保留既有WARNING/CRITICAL-WARNING：PRJ中的SDC列表路径提示、失效的ChipWatcher调试探针、I2C局部时钟/混合扇出等；逐项类型已与旧默认对照。实际执行SDC由settings载入，并已从最终报告和输入清单核验，不能把列表路径告警描述为零告警。
- 历史普通照明kind10宽阴影/孔洞识别失败在修改前后同点复现，仍未解决；本次ENHN只改变显示。未烧板，未提交或推送Git。

### 烧录后核对

上电默认`VIEW ENHN`、`AE5 AUTO`、`TARGET 152 +/-8`，有效测光连续达标后转`LOCK`；上电电机档位为0。SW4打开菜单，K1/K2选项、K3/K4减/加；`AE Y`改变目标，`DETAIL`/`NOISE`改变增强。`VIEW RGB`可对照原图。菜单操作细节及计数方向、ACK/清零流程见本文对应章节。

### 验证与预览

- 核验：`sim/industrial_upgrade_20261102_validation/verification.json`（`verified_no_board_test`，`defaultRun.verified=true`）。
- UI预览：`release_archive/industrial_20261102/ui_menu_page2.png`（真实RTL渲染的测试场景，画面和数值不是上板采集）。
- 归档含本说明、构建记录、最终物理报告、51项通过日志及源码/ROM输入快照；失败中间构建和旧默认另行保留，没有清理用户工作区。
