ji1109-shuai/fpgashare/docs/UI_OVERLAY_20261102.md

# 整机左上角透明信息显示修复

唯一工程：D:/fpgashare/fpgashare (4)/fpgashare。
本轮补齐上一轮视觉增强交付遗漏的 UI 要求。上一版 visual.bit 不包含本轮修复。

## 本轮显示变化

- 删除左侧整块深色底板、边框和标题底色，同时删除每行文字自己的黑底；字形之外直接透传原画面。
- 删除左侧 AE5 状态/测光 Y 和 TARGET/容差两行调试文字。AE 控制及菜单中的 AE Y 调节保留。
- VIEW、EXP、GAIN、计数标题、四类计数、批次状态统一使用 16×16 字库、20 像素行距，从同一列开始。
- 批次状态移至 y=180；显示 RUN、READY、NG / ACK、CLEAR VIEW、COMPLETE。NG 优先于清场提示，避免已有异常被清场文字遮住。
- 根据文字下方像素选择深色/浅色字，亮背光背景使用深色正文，NG 使用红色、完成使用绿色。没有新增大面积背景遮罩。
- 左侧原面板区域不再整块屏蔽已确认目标的框和标签。右侧菜单保留原底板和按键说明，安路图标保留。

本轮唯一变化的生产文件为 user_source/hdl_source/hdmi_mixer.v。216 项修改前生产输入逐项核对；根工程保护清单另行核验。AE、AWB、电机、计数控制、ISP 和视觉增强 RTL 均逐字保留。

## 验证范围

本轮重新执行 7 项回归：两种视频读延迟下的 UI、整机菜单、工业计数、视频模式文字、普通目标标签、零件目标标签。
UI 每种读延迟渲染 10 帧完整 1280×720，检查 704 个菜单字符、44379 个信息字形像素、608421 个透明像素及 4363 个批次状态像素；包含原边框、行间空白和被删除两行的位置。亮/暗背景和五种批次状态均覆盖，测试不依赖 DUT 的字符译码结果。

负对照使用本轮修改前的 mixer 与本轮新测试，在 x=168/y=12 的旧边框像素被正确拒绝，证明新断言能发现旧黑底问题。该失败是预期结果，独立保存在 ui_overlay_negative_20261102_validation。

首次正向仿真的合成背景源 raw 本身出现 X。随后只修正测试平台：背景函数改为 automatic，场景作为显式参数传入，避免静态参数存储被并发调用共享。生产 RTL 未为此改变；修正后的两种读延迟全部通过。初次失败日志保留，未删除或冒充通过。

上一版 30 项 AE/CSI/ISP/增强等功能证据仅对本轮未变逻辑复用，日志与测试输入哈希均核对；不是本轮重新运行 53 分钟 CSI 闭环。证据清楚区分重新执行与复用。

## 构建与交付

最终交付构建为 ui_overlay_r3_build_20261102_214046.json，2026-11-02 22:03:04 完成。复用 r1 综合数据库（全部输入哈希相同），使用 TD 官方 TimingMedium 物理优化策略独立布局布线；不修改原 SDC 或引脚约束。

最终 Setup WNS +0.107 ns、Hold WNS +0.020 ns，两类 TNS 与违例端点均为 0；Routing DRC 三项通过，未出现实现 ERROR/FATAL。STA 覆盖 94.71%；Slice 20018/21216、LUT6 19581/21216、ERAM 80/108、DSP 22/40。余量仍有限，不能当作上板实测。

既有告警仍存在。相较上一版，一个相同时钟混合负载告警的时钟引脚数从 397 降为 384，数据/控制引脚仍为 1，已单独审查记录；未忽略其他新告警。实际执行的约束文件由最终时序报告与源清单双重核对，不能把工程源列表中的旧 SDC 提示说成未执行约束。

r1 虽生成 bit，但 Setup -1.449 ns，不交付；r2 在 TD 全局布局阶段发生工具崩溃，不交付。两轮记录和日志保留，不覆盖默认入口。

交付 release_archive/ui_overlay_20261102/camera_to_dsi_display_ui_overlay.bit，SHA256 724DEB436F016145E36E8FEB7C02875A2A853BCF11366B69A03DF8BE14FABDE8，1789539 字节。最终归档与默认入口同步身份以 sim/ui_overlay_20261102_validation/verification.json 为准。

核验工具：tools/verification/verify_ui_overlay.py。
默认入口安全同步工具：tools/promote_ui_overlay.ps1；仅允许已核验且已归档的本轮 bit，保留旧 syn_1/phy_1 目录，核对 bit、综合数据库、报告、有效源清单和 ROM。

2026-11-02 22:05:20 已同步默认 syn_1/phy_1，并再次核验 defaultRun.verified=true、issues=[]。原默认 visual 版完整保留为 syn_1_before_ui_overlay_20261102_220519 与 phy_1_before_ui_overlay_20261102_220519。归档、最终独立 run 及默认入口三处 bit 哈希一致。

显示预览为 RTL 仿真图。未烧板，不把功能仿真或生成 bit 当作现场相机、背光板、电机或识别效果已实测。
