ji1109-shuai/fpgashare/docs/自动曝光与异常分拣操作说明_v2.md

# PH1P35 自动曝光与异常分拣版操作说明

> 本文描述归档 v3 bit。本次 `(4)/fpgashare` 的新源码已增加“连续稳定后锁定”，当前操作及交付路径见 [AE_ONCE_AND_MOTION_20261101.md](AE_ONCE_AND_MOTION_20261101.md)，不要按本文推断新源码仍只在运动时冻结。

## 1. 对应 Bit 文件

```text
D:\FPGA_competition\fpgashare\release_archive\motion_ae_freeze_v3_20261101\camera_to_dsi_display_motion_ae_freeze_v3.bit
```

SHA-256：

```text
A99EE1BE8A3B8AC637CCBA0531769721E7CABE65D2D73D8E9E61D3D82DAD5CB2
```

最终布局布线结果：

- Setup WNS：`+0.084 ns`；
- Hold WNS：`+0.020 ns`；
- Setup/Hold 违例端点：`0`；
- Slice：`19486 / 21216`，约 `91.85%`；
- ERAM：`76 / 108`，约 `70.37%`；
- DSP：`20 / 40`，约 `50.00%`。

## 2. 自动曝光

菜单新增 `AE` 项：

- `AE:AUTO`：电机档位为 `OFF` 时，系统根据中心背景区域亮度自动调节曝光和增益；
- `AE:MAN`：停止自动调节，由 `EXP` 和 `GAIN` 菜单项手动设置；
- 系统上电默认使用 `AE:MAN`，优先保证传送带检测的实时性；
- 传送带设置为任意非零速度后，即使菜单仍显示 `AE:AUTO`，曝光和增益也会自动冻结在当前值；
- 手动修改 `EXP` 或 `GAIN` 后，系统自动切换到 `AE:MAN`；
- 自动曝光采用亮度死区和连续 4 帧确认，避免参数在临界亮度附近来回跳动；
- 识别到零件时暂停自动曝光，防止深色或高反光零件经过时引起画面亮度呼吸。

建议先将 `MOTOR` 保持为 `OFF`，需要展示自动曝光时再选择 `AE:AUTO`。画面稳定后启动传送带，系统会自动锁住曝光。正式检测也可以一直使用默认的 `AE:MAN`，通过背光板调整照明。

## 3. 精确数量与异常停机

系统同时维护螺钉、垫圈、六角螺母和四方螺母四类的实际数量与目标数量。

- 所有非零目标都恰好满足：正常批次完成，传送带保持停止；
- 任一类别超过目标：判定为异常超额，传送带立即停止；
- 超额类别的计数行变为红色；
- 系统保留真实超额计数，不会静默截断，从而避免掩盖送料错误；
- 其他类别的计数不会被清除。

例如目标为：

```text
SCR 002 / WAS 001 / HEX 001 / SQU 000
```

若螺钉已经达到 3 个，而垫圈尚未达到 1 个，系统会立即停带，并将螺钉一行标红。

## 4. 模拟异常分拣与自动恢复

异常停机后的操作流程：

1. 观察红色计数行，确认超额类别；
2. 从摄像头画面中抽走该类别的异常零件；
3. 保持该类别不再出现在画面中；
4. 系统连续确认 3 次目标发布均未看到该异常类别；
5. 将该类别计数从超额值回退到目标值；
6. 清除异常状态；
7. 传送带按停机前记忆的速度自动继续运行；
8. 其他类别继续完成剩余目标。

为防止手部遮挡或识别框瞬时丢失造成误启动，系统不会在异常零件刚消失的一帧内立即恢复。

如果抽走异常件后四类目标已经全部满足，系统转入正常批次完成状态，传送带不会重新启动。

## 5. 菜单顺序

打开 `SW4` 后，菜单顺序为：

1. `VIEW`：图像显示模式；
2. `MOTOR`：传送带速度；
3. `AWB`：自动白平衡/锁定；
4. `AE`：自动曝光/手动曝光；
5. `EXP`：手动曝光值；
6. `GAIN`：手动增益值；
7. `SCR`：螺钉目标数；
8. `WAS`：垫圈目标数；
9. `HEX`：六角螺母目标数；
10. `SQU`：四方螺母目标数；
11. `RESET COUNTS`：清零四类计数和异常状态。

按键保持不变：`KEY1/KEY2` 上下移动，`KEY3/KEY4` 减少/增加或执行当前功能。

## 6. 验收演示建议

1. 设置螺钉目标 1、垫圈目标 1，其他类别为 0；
2. 将电机设置为 53% 或 56%；
3. 先通过 1 个螺钉，再额外送入第 2 个螺钉；
4. 展示螺钉计数标红且传送带立即停止；
5. 抽走画面中的异常螺钉；
6. 展示系统自动解除异常并恢复原速度；
7. 再送入 1 个垫圈；
8. 展示所有目标完成后传送带正常停止。

> 当前“异常”指类别数量超额。外观缺陷、尺寸不合格和未知类别自动剔除不属于本版本的可靠判定范围。
