ji1109-shuai/fpgashare/docs/MORPH_DAMAGE_20261022.md

# 零件二值形态处理与反光缺口（2026-10-22）

## 当前实现

识别器在每帧全局灰度直方图阈值后，将图像压为 8x8 像素单元掩膜；任一单元中至少 32 个二值前景样本才计为掩膜前景。之后已经执行一次 3x3 闭运算：膨胀再腐蚀。它能桥接接近一个单元尺度（约 8 像素）的窄反光断口。后续连通域选择主要零件，孔洞分析只接受零件内部封闭区域，因此小的分离阴影岛通常不会改变主轮廓。

这是识别器内部的低分辨率掩膜处理，不等于 SW2/SW3 的全分辨率预览形态学。当前显示预览的四级腐蚀/膨胀没有连接到零件识别输入。

## 本轮试验

- 新增完整垫圈合成样例，在轮廓处遮掉约 4 像素宽的反光带，并在中心孔内加入离散暗点；按当前闭运算和连通域/孔洞路径，轮廓仍确认成垫圈。
- 原 70 帧零件形状、颜色和多目标无手动校准回归通过；无手动校准四目标回归覆盖目标更换、颜色变化、溢出、清空及无背板。
- 曾评估对全局掩膜追加开运算以清除暗点。完整六角螺母测试失败，真实轮廓/孔结构被腐蚀；该实验没有保留在源码中。
- 本次没有提高分割阈值、改变形态学窗口或改动 AWB/RGB 数据路径。有效代码提交起点仍是 `50b4667`；本记录和回归扩展作为单独提交保存。

## 限制与后续路线

闭运算只能修补结构元素尺度内的窄断口。它不能填回大块高光造成的整片缺失，也不会恢复 RGB 通道里已经饱和或被补偿洗白的颜色。开运算全局施加会伤害螺母内孔和窄边，不能因为二值看起来更平滑就默认有利于形状分类。

如果必须降低对白色背板强对比的依赖，候选方案是局部背景估计/自适应阈值，或固定相机的空背板参考差分。两者都需要在 FPGA 资源和时序约束下设计，且可能把物体自身缓慢变化的明暗当背景。先收集板上反光缺口大小、阴影点大小和相邻目标间距，再选窗口；形态处理半径必须小于真实零件窄边与物体间距。

本次功能仿真只使用人工图像模型，不证明真实摄像头光照下分类稳定、物理时序收敛或资源足够。当前下一步板上检查应保持 EXP/GAIN 不变，分别观察未处理二值外形与最终类型，并确认缺口和阴影的大致像素尺度。
