ji1109-shuai/fpgashare/docs/figures/algorithm_four_modules_20261103/module_descriptions.md

# 2.3 算法与控制逻辑介绍

## 2.3.2 自适应成像与视觉增强

如图所示，系统通过独立曝光反馈与自动白平衡稳定成像，再在显示支路进行视觉增强。曝光控制使用AWB前的有效亮度反馈，以目标亮度±8为允许范围；默认目标为152，可通过菜单调整。亮度连续偏离同一侧时优先调整曝光，曝光到达边界后再补偿增益，并在寄存器更新后等待生效，避免旧测光反馈参与收敛判断。连续16个有效测光包处于允许范围后进入LOCK，保持曝光和增益；重新启用AUTO或在AUTO/LOCK下改变目标可启动新一轮调节。

白平衡在图像中筛选候选中性像素，排除暗区、明显彩色和过曝样本；合格样本不少于1024时，根据G/R、G/B估计并平滑R、B补偿，样本不足时保持最近有效补偿。显示增强采用带软噪声门限的局部细节强化，串接亮度S曲线和色差回加，突出螺纹、轮廓及明暗层次。DETAIL和NOISE分别提供强度与噪声门限调节，并支持同帧原图/增强对照。增强结果只用于显示，不反馈到曝光测光或识别分类。

配图：01_adaptive_imaging.png
建议图题：自适应成像与视觉增强算法流程。

## 2.3.3 多目标识别算法

系统以白平衡后的RGB图像为输入，根据背景亮度统计更新前景分割阈值，并在8×8网格上压缩记录前景和颜色信息。经3×3闭运算修补局部断裂后，利用连通区域分析定位目标，并提取外接框、面积及孔洞等空间特征。形状判别结合外形比例、孔洞结构与轮廓分布，区分螺丝、垫圈、六角螺母和四方螺母；颜色判别使用HSV色相不等式及亮度、色度约束，对前景颜色证据进行统计，证据不足时保留未知状态。

候选结果通过位置、尺寸、类别及位移预测辅助匹配建立跨批次身份关联，分别确认形状与颜色，并为短时漏检保留历史信息。关联身份采用槽位与代际标记区分，避免新零件沿用旧目标的计数状态。完整发布的位置、类别、身份及有效标记同时供显示、越线计数与批次保护使用。

配图：02_multi_target_recognition.png
建议图题：多目标特征识别与身份关联流程。

## 2.3.4 动态计数与批次控制

动态计数以目标身份和输送方向共同约束。目标先在计数线上游建立布防，同一身份越过下游滞回边界且尚未计数时，产生一次分类计数；目标在下游停留或被重复检测不会再次累计。系统同时检查各类目标与批次配额，配额为零的已确认类别在运行/保护相关状态下可于上游直接触发NG，无需等待越线；全部需求配额满足后进入COMPLETE并保持停车。

普通错料或超额触发停机和间歇蜂鸣，并保留原运行档位。移除异常类别后，连续三次新的完整检测结果均确认该类别不在场，才允许解除普通NG；若操作员未选择STOP且批次未完成，可按保留档位恢复。身份歧义、检测容量等故障还需满足清除条件并执行ACK。超额恢复仅修剪本批接受数量，PASS累计通过数量保留；新批次须重新经过清场，防止残留目标被当作新料计入。

配图：03_counting_batch_control.png
建议图题：身份越线计数与批次异常状态转换。

## 2.3.5 显示交互与性能统计

显示模块将实时图像与已确认目标框、类别标签、配额计数、批次状态和菜单进行OSD叠加。按键与拨码输入经同步和消抖后生成操作事件，由菜单状态机完成项目选择、数值修改和动作确认，使成像、增强、配额及电机控制参数可现场调整。

FPS在ISP输出端统计完整帧：只有帧首后累计收到172800个128位有效字，才记为一帧；完成事件同步至50 MHz系统域后，以1秒窗口发布帧率，再由显示域在帧首锁存。DET从识别器实际接受帧首开始计时，到该批全部目标结果发布结束，显示单位为0.1 ms，空场批次也参与计时。两类统计均属于旁路观察，不增加像素通路延迟；FPS不代表HDMI刷新率，DET不等同于视频端到端延迟。

配图：04_ui_performance.png
建议图题：显示界面与菜单、帧率及检测耗时统计流程。

## 图中数据与来源

图2与图4的实拍示例使用用户已提供照片，保留原画面中的识别结果、计数和性能读数，仅进行等比例排版及标注。流程图依据当前整机工程的生产实现整理，不是现场性能测量报告。工程入口为D:/fpgashare/fpgashare (4)/fpgashare/td_project/camera_to_dsi_display.al。
