ji1109-shuai/fpgashare/mechanical/camera_mount/preview.png

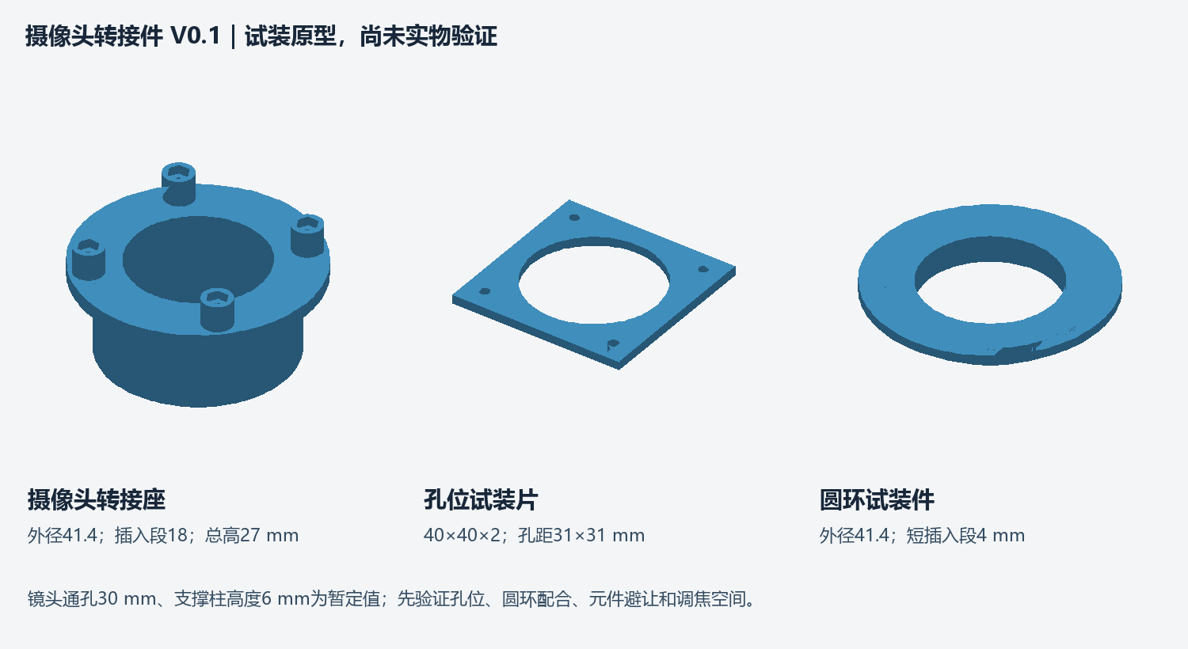
mechanical/camera_mount/preview.png
