ji1109-shuai/fpgashare/mechanical/camera_mount/camera_mount.3mf

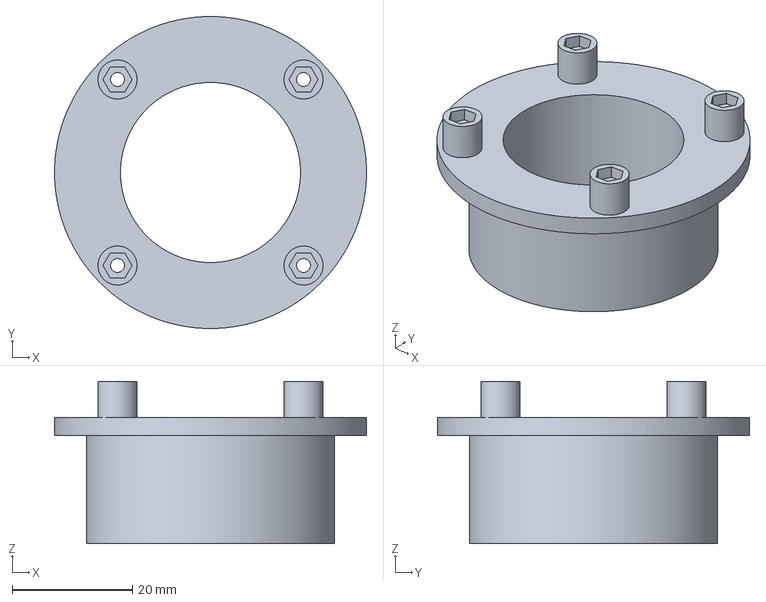
[picture p2: CAD file, 2026-11-04]
mechanical/camera_mount/camera_mount.3mf
52.0 x 52.0 x 27.0 mm
