ji1109-shuai/fpgashare/mechanical/camera_mount/hole_coupon.stl

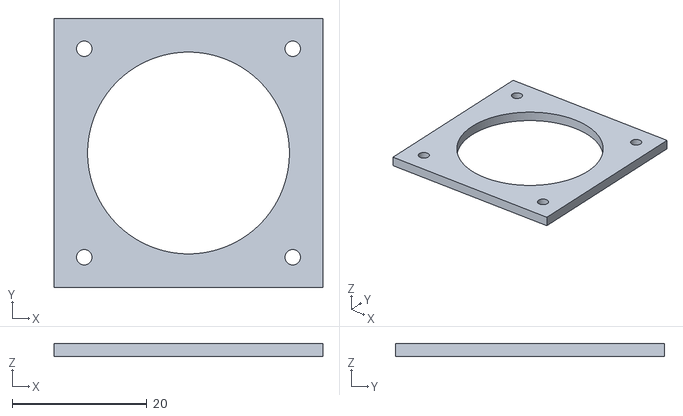
[picture p3: CAD file, 2026-11-04]
mechanical/camera_mount/hole_coupon.stl
40.0 x 40.0 x 2.00
