ji1109-shuai/fpgashare/mechanical/camera_mount/ring_coupon.stl

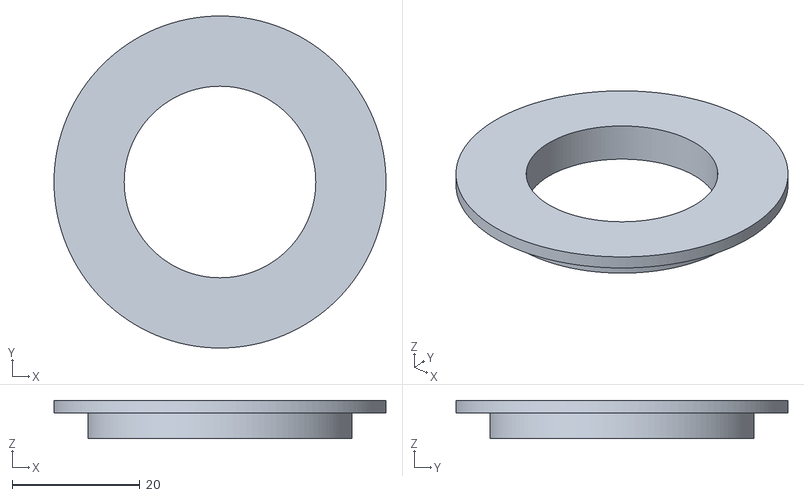
[picture p4: CAD file, 2026-11-04]
mechanical/camera_mount/ring_coupon.stl
52.0 x 52.0 x 6.00
