ji1109-shuai/fpgashare/(list of files, cad)

Other CAD files:
mechanical/camera_mount/camera_mount.stl
