ji1109-shuai/fpgashare/docs/COLOR_GLARE_VALIDATION.md

# 反光下的颜色投票修正与上板核验

日期：2026-10-19。此项修改针对颜色过亮后被误判为银色，功能仿真不能代替现场验证。

**已撤回：当前源码已恢复实验前的颜色规则，并取消生产配置的白纸校准/锁定要求。本文以下代码、命令（含已删除的 `tb_parts_glare`）、校准和上板步骤均为历史记录，不适用于当前工作区。当前说明见 [COLOR_NO_CALIBRATION_20261019.md](COLOR_NO_CALIBRATION_20261019.md)。**

**现场状态更新：用户反馈本版黄铜色被识别为红色、黑色被识别为 UNKN，未通过现场颜色验收。下面保留的是实验实现和当时的仿真记录，不再推荐据此反复构建。边界复核和后续方法见 [COLOR_METHOD_REVIEW_20261019.md](COLOR_METHOD_REVIEW_20261019.md)。**

## 现场条件

用户已反馈：使用底部背光和室内环境光；白纸校准后打开 SW4 锁定，移开白纸，EXP/GAIN 保持不变。可以让画面中的白色恢复正常，但零件颜色仍容易因过亮被识别成银色。这说明本次应检查颜色取样和分类，不能仅反复要求用户重新白平衡或降低曝光。

“能够正常白”是新的现场反馈，不代表原偏绿问题的完整根因已经定位，也不代表所有颜色已经正确。

## 本次改变

改动集中在 `user_source/hdl_source/img_proj.v` 的颜色分支，不改变 AWB、ISP 输出、DDR、Sobel/EDGE、形状分割、目标关联与安路图标。

1. 像素层：收紧中性色范围，保留可靠红色比例，弱色偏留在不确定区；中性像素最大通道达到 224 后不再作为银色证据。原来任一通道达到 250 的拒绝规则保留。224 是当前 8 位 RGB 的经验初值，不是相机的物理饱和标定。
2. 小块层：每个 8×8 小块在压缩成一个颜色标签前，允许有足够证据的红色/黄铜色抵抗灰白反光。要求至少 8 个对应像素、占已分类像素至少 1/4、相对另一暖色至少 2:1，且比黑色像素更多。已分类像素总数仍须至少 16。红黑平分等冲突不能直接选红色。
3. 小块里的银色：仅在红色、黄铜色各少于 8 个像素且满足原有支持比例时允许输出；少量色彩噪声不会直接改变银色，存在实际但不足以定类的暖色证据时可以输出未知。
4. 整件层：红色/黄铜色至少 8 个小块、占已分类小块至少 1/4，并相对另一暖色至少 2:1。银色不能在已有至少 8 个红色或黄铜色小块时，直接依靠多数灰白小块胜出。样本覆盖率、黑色支持和跨帧确认仍保留。

上述比例是可验证的首版规则，不保证适配所有光谱和所有金属。全部通道都变成相同的白色时，颜色信息已经丢失，不能依靠投票恢复真实颜色。

本次保留原有前景/内部取样结构；没有实现从任意背景提取全部物体表面像素。黑色/银色的像素亮度划分仍使用原白参考亮度，不应描述成已完成完全独立于白参考的颜色系统。后续若该项仍不稳定，需要目标亮度分布和实际样本进一步验证。

## 回归入口

在仓库根目录使用 PowerShell 执行，输出目录带 `validation`，构建缓存不会入库：

```powershell
& ./sim/run_colour_stability_regression.ps1 -BuildName glare_colour_validation -Tops tb_colour_ratios,tb_wb_reference,tb_wb_invalid,tb_multi_overlay,tb_wb_probe_isp
& ./sim/run_parts_regression.ps1 -BuildName glare_parts_validation -Tops tb_parts_colours,tb_parts_colour_stability,tb_parts_multi,tb_parts_shape_pipeline
& ./sim/run_parts_regression.ps1 -BuildName glare_target_validation -Tops tb_parts_glare
```

`tb_parts_glare` 专门覆盖：小块内 75% 灰白反光、小块之间的灰白反光分布、红色和黄铜色保留、不足量颜色拒绝、单点杂色不改变银色、弱色偏不直接归银色。

`tb_parts_multi` 在原有四目标、移除、换序、校准变化、溢出等场景中新增反光：银色、红色、黑色、黄铜色四目标同帧，红色和黄铜色各有 75% 灰白反光。反光像素为人工构造的 RGB，不是真实曝光/反射的完整光学模型。

旧版复现使用基线提交 `4f32b30` 的 `img_proj.v` 和新的 `tb_parts_glare`，在第二次观察中出现：

```text
Fatal: colour surface5 rgbc03838 got5 expected1 votes0/122/0 total105 raw5 streak2
```

含义为红色物体被输出为银色；这证明旧投票会丢掉这组样本中的红色信息，不证明现场误判只有这一个原因。

本次 10 个独立功能测试顶层全部通过，覆盖上述反光、颜色比例、白平衡、多目标、形状流水线与显示叠加。逐项结果见 [COLOR_GLARE_RESULTS_20261019.txt](COLOR_GLARE_RESULTS_20261019.txt)。未进行 TD 综合、布局布线、bit 生成或现场验证。

## 用户上板操作

1. 关闭 TD 中旧的工程副本，确认打开本仓库的 `td_project/camera_to_dsi_display.al`。本次源码在 `codex/colour-glare-voting` 分支，不能误用 `main` 的旧代码。
2. 用户自行综合、布局布线，检查全部时序违例，再生成和下载 bit。没有新的 TD 报告之前，不能声称本版时序通过。
3. 保持目前能稳定框选的 EXP/GAIN、摄像头高度和灯光，不要为每个零件单独更改。RGB 原图模式下，在实际检测平面放白纸覆盖中心参考区，关闭 SW4，等到参考收敛后打开 SW4，确认 `WB:LOCK REF:OK`，再移开白纸。
4. 先分别放银色、红色和黄铜色零件，再同屏放置，物体互不接触；等待两秒，观察框上颜色。随后在检测范围内移动和旋转，观察是否仍只在某个位置误判。
5. 如仍有错误，请回传整屏照片，让目标、颜色标签和诊断字都可读。记录实物真实颜色、屏幕判定、EXP/GAIN、WB/REF 以及照明是否变化。可以先把有问题的物体单独放置，以便诊断区代表它；当前详细颜色诊断主要对应第一个目标。

预期是减少“有明显红/黄铜证据却被反光多数票判成银色”，部分弱色偏目标可能从银色变为 `UNKN`。这不应被解释为所有颜色都已稳定。

白纸校准无需在每次换件时重做，但实际照明或相机参数变化后需要重新确认。底部背光主要帮助轮廓，若物体正面没有足够可用的色彩信息，后续应在固定平台增加柔和的正面/侧面白光。更换为绿色流水线时，还需单独修改当前寻找白色背板的分割规则，本次没有实现该功能。
