ji1109-shuai/fpgashare/user_source/hdl_source/osd_char_lib.v

module osd_char_lib (
    input wire [7:0] I_char,
    input wire [3:0] I_row,
    output reg [15:0] O_row_bits
);

    localparam CHAR_AN    = 8'h80;
    localparam CHAR_LU    = 8'h81;
    localparam CHAR_A     = 8'h41;
    localparam CHAR_B     = 8'h42;
    localparam CHAR_C     = 8'h43;
    localparam CHAR_D     = 8'h44;
    localparam CHAR_E     = 8'h45;
    localparam CHAR_F     = 8'h46;
    localparam CHAR_G     = 8'h47;
    localparam CHAR_H     = 8'h48;
    localparam CHAR_I     = 8'h49;
    localparam CHAR_J     = 8'h4a;
    localparam CHAR_K     = 8'h4b;
    localparam CHAR_L     = 8'h4c;
    localparam CHAR_M     = 8'h4d;
    localparam CHAR_N     = 8'h4e;
    localparam CHAR_O     = 8'h4f;
    localparam CHAR_P     = 8'h50;
    localparam CHAR_Q     = 8'h51;
    localparam CHAR_R     = 8'h52;
    localparam CHAR_S     = 8'h53;
    localparam CHAR_T     = 8'h54;
    localparam CHAR_U     = 8'h55;
    localparam CHAR_V     = 8'h56;
    localparam CHAR_W     = 8'h57;
    localparam CHAR_X     = 8'h58;
    localparam CHAR_Y     = 8'h59;
    localparam CHAR_Z     = 8'h5a;
    localparam CHAR_0     = 8'h30;
    localparam CHAR_1     = 8'h31;
    localparam CHAR_2     = 8'h32;
    localparam CHAR_3     = 8'h33;
    localparam CHAR_4     = 8'h34;
    localparam CHAR_5     = 8'h35;
    localparam CHAR_6     = 8'h36;
    localparam CHAR_7     = 8'h37;
    localparam CHAR_8     = 8'h38;
    localparam CHAR_9     = 8'h39;
    localparam CHAR_COLON = 8'h3a;

    always @(*) begin
        case(I_char)
            CHAR_AN: begin
                case(I_row)
                    4'd0: O_row_bits = 16'h0200;
                    4'd1: O_row_bits = 16'h7ff0;
                    4'd2: O_row_bits = 16'h4410;
                    4'd3: O_row_bits = 16'h0400;
                    4'd4: O_row_bits = 16'h7ff0;
                    4'd5: O_row_bits = 16'h0840;
                    4'd6: O_row_bits = 16'h1040;
                    4'd7: O_row_bits = 16'h1c80;
                    4'd8: O_row_bits = 16'h0300;
                    4'd9: O_row_bits = 16'h0cc0;
                    4'd10: O_row_bits = 16'h7020;
                    4'd11: O_row_bits = 16'h0000;
                    4'd12: O_row_bits = 16'h0000;
                    4'd13: O_row_bits = 16'h0000;
                    4'd14: O_row_bits = 16'h0000;
                    4'd15: O_row_bits = 16'h0000;
                    default: O_row_bits = 16'h0000;
                endcase
            end
            CHAR_LU: begin
                case(I_row)
                    4'd0: O_row_bits = 16'h79e0;
                    4'd1: O_row_bits = 16'h4a20;
                    4'd2: O_row_bits = 16'h4d40;
                    4'd3: O_row_bits = 16'h7880;
                    4'd4: O_row_bits = 16'h1140;
                    4'd5: O_row_bits = 16'h1630;
                    4'd6: O_row_bits = 16'h5be0;
                    4'd7: O_row_bits = 16'h5220;
                    4'd8: O_row_bits = 16'h5220;
                    4'd9: O_row_bits = 16'h5be0;
                    4'd10: O_row_bits = 16'h6220;
                    4'd11: O_row_bits = 16'h0000;
                    4'd12: O_row_bits = 16'h0000;
                    4'd13: O_row_bits = 16'h0000;
                    4'd14: O_row_bits = 16'h0000;
                    4'd15: O_row_bits = 16'h0000;
                    default: O_row_bits = 16'h0000;
                endcase
            end
            CHAR_A: begin
                case(I_row)
                    4'd0: O_row_bits = 16'h0000;
                    4'd1: O_row_bits = 16'h0000;
                    4'd2: O_row_bits = 16'h1c00;
                    4'd3: O_row_bits = 16'h1400;
                    4'd4: O_row_bits = 16'h1400;
                    4'd5: O_row_bits = 16'h1400;
                    4'd6: O_row_bits = 16'h3600;
                    4'd7: O_row_bits = 16'h3e00;
                    4'd8: O_row_bits = 16'h2200;
                    4'd9: O_row_bits = 16'h2200;
                    4'd10: O_row_bits = 16'h0000;
                    4'd11: O_row_bits = 16'h0000;
                    4'd12: O_row_bits = 16'h0000;
                    4'd13: O_row_bits = 16'h0000;
                    4'd14: O_row_bits = 16'h0000;
                    4'd15: O_row_bits = 16'h0000;
                    default: O_row_bits = 16'h0000;
                endcase
            end
            CHAR_B: begin
                case(I_row)
                    4'd0: O_row_bits = 16'h0000;
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
                    4'd0: O_row_bits = 16'h0000;
                    4'd1: O_row_bits = 16'h1ff8;
                    4'd2: O_row_bits = 16'h1ff8;
                    4'd3: O_row_bits = 16'h300c;
                    4'd4: O_row_bits = 16'h300c;
                    4'd5: O_row_bits = 16'h300c;
                    4'd6: O_row_bits = 16'h1ff8;
                    4'd7: O_row_bits = 16'h1ff8;
                    4'd8: O_row_bits = 16'h300c;
                    4'd9: O_row_bits = 16'h300c;
                    4'd10: O_row_bits = 16'h300c;
                    4'd11: O_row_bits = 16'h1ff8;
                    4'd12: O_row_bits = 16'h1ff8;
                    4'd13: O_row_bits = 16'h0000;
                    4'd14: O_row_bits = 16'h0000;
                    4'd15: O_row_bits = 16'h0000;
                    default: O_row_bits = 16'h0000;
                endcase
            end
            CHAR_9: begin
                case(I_row)
                    4'd0: O_row_bits = 16'h0000;
                    4'd1: O_row_bits = 16'h1ff8;
                    4'd2: O_row_bits = 16'h1ff8;
                    4'd3: O_row_bits = 16'h300c;
                    4'd4: O_row_bits = 16'h300c;
                    4'd5: O_row_bits = 16'h300c;
                    4'd6: O_row_bits = 16'h1ff8;
                    4'd7: O_row_bits = 16'h1ff8;
                    4'd8: O_row_bits = 16'h000c;
                    4'd9: O_row_bits = 16'h000c;
                    4'd10: O_row_bits = 16'h000c;
                    4'd11: O_row_bits = 16'h1ff8;
                    4'd12: O_row_bits = 16'h1ff8;
                    4'd13: O_row_bits = 16'h0000;
                    4'd14: O_row_bits = 16'h0000;
                    4'd15: O_row_bits = 16'h0000;
                    default: O_row_bits = 16'h0000;
                endcase
            end
            8'h2d: O_row_bits=(I_row==7 || I_row==8) ? 16'h0ff0:16'h0000; // -
            8'h2e: O_row_bits=(I_row==11 || I_row==12) ? 16'h0180:16'h0000; // .
            8'h2f: begin // /
                case(I_row)
                    4'd2: O_row_bits=16'h0060;
                    4'd3: O_row_bits=16'h00c0;
                    4'd4: O_row_bits=16'h0180;
                    4'd5: O_row_bits=16'h0300;
                    4'd6: O_row_bits=16'h0600;
                    4'd7: O_row_bits=16'h0c00;
                    4'd8: O_row_bits=16'h1800;
                    4'd9: O_row_bits=16'h3000;
                    default: O_row_bits=16'h0000;
                endcase
            end
            8'h6d: begin // m
                case(I_row)
                    5,6:O_row_bits=16'h3660;
                    7,8,9,10,11,12:O_row_bits=16'h4990;
                    default:O_row_bits=16'h0000;
                endcase
            end
            8'h73: begin // s
                case(I_row)
                    5,6,8,9,11,12:O_row_bits=16'h0ff0;
                    7:O_row_bits=16'h1800;
                    10:O_row_bits=16'h0018;
                    default:O_row_bits=16'h0000;
                endcase
            end
            CHAR_COLON: begin
                case(I_row)
                    4'd0: O_row_bits = 16'h0000;
                    4'd1: O_row_bits = 16'h0000;
                    4'd2: O_row_bits = 16'h0000;
                    4'd3: O_row_bits = 16'h0000;
                    4'd4: O_row_bits = 16'h0000;
                    4'd5: O_row_bits = 16'h0000;
                    4'd6: O_row_bits = 16'h0180;
                    4'd7: O_row_bits = 16'h0180;
                    4'd8: O_row_bits = 16'h0000;
                    4'd9: O_row_bits = 16'h0000;
                    4'd10: O_row_bits = 16'h0180;
                    4'd11: O_row_bits = 16'h0180;
                    4'd12: O_row_bits = 16'h0000;
                    4'd13: O_row_bits = 16'h0000;
                    4'd14: O_row_bits = 16'h0000;
                    4'd15: O_row_bits = 16'h0000;
                    default: O_row_bits = 16'h0000;
                endcase
            end
            default: O_row_bits = 16'h0000;
        endcase
    end

endmodule


// Synchronous ERAM ROM: exactly replaces the existing P3 register latency.
module osd_font_sync(input I_clk,input [7:0] I_char,input [3:0] I_row,
    output reg [15:0] O_row_bits);
    (* ram_style="bram" *) reg [15:0] font_rows[0:2047];
    initial $readmemh("industrial_font16.hex",font_rows);
    always @(posedge I_clk) O_row_bits<=font_rows[{I_char[6:0],I_row}];
endmodule
