ji1109-shuai/fpgashare/sim/tb_ae_chain.sv

`timescale 1ns/1ps
// Real production meter -> CDC/controller -> gain ROM -> register sequencer ->
// bit-level I2C slave -> sensor-register-based synthetic RGB feedback.
// No injected mean and no fake cfg_done/busy pulse in this test.
module tb_ae_chain #(
    parameter integer INITIAL_EXP=2244,LIGHT=100,START_MOTOR=0,NACK_ONCE=0,NACK_BOOT=0,REAL_ISP=0,CSI_INPUT=0,TARGET_LEVEL=19,RETARGET=0,
    parameter integer EXPECT_EXP_CHANGE=1,EXPECT_GAIN_CHANGE=0,PREVIEW_ENHANCE=0
);
    localparam W=REAL_ISP?1280:128,H=REAL_ISP?720:96;
    reg clk=0,cfg_clk=0,rst_n=0,valid=0,sof=0,last=0;
    always #5 clk=~clk;
    always #7 cfg_clk=~cfg_clk;
    reg [95:0] rgb=0;
    reg hs_valid=0;
    reg [15:0] hs_data=0;
    integer csi_native_beats=0,csi_corrected_beats=0;
    wire [7:0] meter;
    wire meter_valid,meter_upd;
    generate if(!REAL_ISP) begin : g_meter
    camera_exposure_meter #(.IMG_WIDTH(W),.IMG_HEIGHT(H)) meter_dut(
        .I_clk(clk),.I_rst_n(rst_n),.I_tdata(rgb),.I_tvalid(valid),
        .I_tuser(sof),.I_tlast(last),.O_luma(meter),.O_valid(meter_valid),.O_upd(meter_upd));
    end else begin : g_full_isp
        wire [39:0] raw_data,isp_data;
        wire isp_valid,isp_sof,isp_last;
        for(genvar p=0;p<4;p=p+1) begin : g_raw
            assign raw_data[p*10+:10]={rgb[(3-p)*24+16+:8],2'b00};
        end
        if(CSI_INPUT) begin : g_csi
            wire frame_start,frame_end,csi_valid,raw_sof,raw_end,raw_valid;
            wire [31:0] csi_data;
            wire [39:0] raw_native,axis_data;
            wire axis_valid,axis_sof,axis_last;
            csi_unpacket_2lane csi(.I_clk(clk),.I_rst_n(rst_n),
                .I_hs_valid(hs_valid),.I_hs_data(hs_data),
                .O_csi_frame_start(frame_start),.O_csi_frame_end(frame_end),
                .O_csi_valid(csi_valid),.O_csi_data(csi_data));
            raw10_unpacket_2lane raw10(.I_clk(clk),.I_rst_n(rst_n),
                .I_csi_frame_start(frame_start),.I_csi_frame_end(frame_end),
                .I_csi_valid(csi_valid),.I_csi_data(csi_data),.I_camera_black_level(10'd0),
                .O_raw10_frame_start(raw_sof),.O_raw10_frame_end(raw_end),
                .O_raw10_valid(raw_valid),.O_raw10_data(raw_native));
            uial2axis #(.IMG_WIDTH(W),.IMG_HEIGHT(H),.INPUT_DATA_WIDTH(40)) axis(
                .I_native_clk(clk),.I_rst_n(rst_n),.I_data(raw_native),
                .I_data_valid(raw_valid),.I_data_start(raw_sof),.I_data_end(raw_end),
                .axis_tvalid(axis_valid),.axis_tuser(axis_sof),.axis_tlast(axis_last),.axis_tdata(axis_data));
            image_correction #(.DATA_WIDTH(40)) correction(.I_clk(clk),.I_rst_n(rst_n),
                .I_raw_data(axis_data),.I_raw_valid(axis_valid),
                .I_raw_frame_start(axis_sof),.I_raw_frame_end(axis_last),
                .O_raw_tdata(isp_data),.O_raw_tvalid(isp_valid),
                .O_raw_tuser(isp_sof),.O_raw_tlast(isp_last),.O_raw_tready(1'b1));
            always @(posedge clk) if(rst_n) begin
                if(raw_valid) csi_native_beats=csi_native_beats+1;
                if(isp_valid) csi_corrected_beats=csi_corrected_beats+1;
            end
        end else begin : g_direct
            assign isp_data=raw_data;
            assign isp_valid=valid;
            assign isp_sof=sof;
            assign isp_last=last;
        end
        isp_top #(.TIRE_MODE(1),.PARTS_MODE(1),.VIDEO_MODES(1),
            .AUTO_WHITE_BALANCE(1),.MULTI_TARGETS(1)) isp(
            .axi4s_video_aclk(clk),.I_rst_n(rst_n),.I_tlast(isp_last),.I_tuser(isp_sof),
            .I_tdata(isp_data),.I_tvalid(isp_valid),.I_tdest(10'd0),.O_tready(1'b1),
            .I_bin_en(PREVIEW_ENHANCE!=0),.I_morph_mode(PREVIEW_ENHANCE ? 2'd3:2'd0),.I_awb_freeze(1'b0),
            .I_enhance_strength(2'd2),.I_enhance_noise(4'd4),.I_enhance_compare(1'b0),
            .I_camera_status(29'd0),.I_camera_status_upd(1'b0),
            .O_ae_luma(meter),.O_ae_valid(meter_valid),.O_ae_upd(meter_upd));
    end endgenerate
    reg menu_switch=0;
    reg [3:0] buttons=4'hf;
    wire menu_open,auto_enable,camera_keys_armed,target_upd;
    wire [4:0] target_level;
    wire [3:0] menu_index;
    wire [2:0] motor_level;
    wire adjust_toggle,adjust_gain,adjust_up;
    screen_menu_control #(.DEBOUNCE_CYCLES(3)) menu(
        .clk(clk),.rst_n(rst_n),.I_menu_switch(menu_switch),.I_button_n(buttons),
        .I_batch_done(1'b0),.O_menu_open(menu_open),.O_menu_index(menu_index),
        .O_ae_auto(auto_enable),.O_motor_level(motor_level),
        .O_camera_keys_armed(camera_keys_armed),
        .O_ae_target_level(target_level),.O_ae_target_upd(target_upd),
        .O_camera_adjust_toggle(adjust_toggle),.O_camera_adjust_gain(adjust_gain),
        .O_camera_adjust_up(adjust_up));
    wire req,locked,cam_done,ae_done;
    wire [15:0] exposure,gain;
    ae_set #(.CLK_HZ(1000),.EXP_DEFAULT(INITIAL_EXP),.DYNAMIC_TARGET(1)) ae(
        .I_clk(cfg_clk),.I_rst(!rst_n),.I_btn((menu_open || !camera_keys_armed)?4'hf:{buttons[1:0],2'b11}),
        .I_ae_cfg_done(ae_done),.I_cam_cfg_done(cam_done),
        .I_menu_adjust_toggle(adjust_toggle),.I_menu_adjust_gain(adjust_gain),
        .I_menu_adjust_up(adjust_up),.I_auto_enable(auto_enable),
        .I_target_level(target_level),.I_target_upd(target_upd),
        .I_luma(meter),.I_luma_valid(meter_valid),.I_luma_upd(meter_upd),
        .O_ae_req(req),.O_ae(exposure),.O_ag(gain),.O_auto_locked(locked));
    wire scl;
    tri1 sda;
    uicfgcs500 #(.CLK_DIV(7)) camera(
        .I_clk(cfg_clk),.I_rst_n(rst_n),.I_ae_req(req),.I_ae(exposure),.I_ag(gain),
        .O_cam_scl(scl),.IO_cam_sda(sda),.O_cfg_done(cam_done),.O_ae_cfg_done(ae_done));
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
