ji1109-shuai/fpgashare/sim/tb_industrial_ui.sv

`timescale 1ns/1ps
module industrial_ui_check #(parameter READ_LATENCY=0);
    reg clk=0,rst_n=0,de=0,sof=0,last=0,menu=1,upd=0;
    reg [3:0] selection=0;
    reg compare=0;
    reg batch_ng=0,batch_done=0,wait_clear=0;
    reg [2:0] motor=2;
    reg [3:0] ng_mask=0;
    reg [23:0] raw=0,d1=0,d2=0;
    wire [23:0] out;
    wire ov;
    integer x,y,scenario,pixels=0,fd=0,text_checks=0,background_checks=0;
    reg [127:0] expected_line;
    integer item;
    integer hx,hy,hrow,hcol,glyph_checks=0,transparent_checks=0,status_checks=0;
    reg [15:0] font_rows[0:2047];
    reg [127:0] hud_line;
    reg [7:0] hud_char;
    reg [23:0] expected_pixel,hud_color;
    reg light_bg;
    initial $readmemh("industrial_font16.hex",font_rows);
    always #5 clk=~clk;
    always @(posedge clk) begin d1<=raw;d2<=d1;end
    function automatic [23:0] background(input integer xx,yy,sc);
        background=sc>=5 && sc<9 ? 24'he2e6ea : sc==9 ? 24'h18202a : {8'(xx),8'(yy),8'(xx^yy)};
    endfunction
    hdmi_mixer #(.VIDEO_READ_LATENCY(READ_LATENCY),.TARGET_ONLY(1),.PARTS_MODE(1),
        .CAMERA_CONTROL(1),.AE_DIAGNOSTICS(1),.DISPLAY_MODES(1),.SHOW_LOGO(1),.MULTI_TARGETS(1),.LATENCY_DIAGNOSTICS(1),.FPS_DISPLAY(1)) dut(
        .I_clk(clk),.I_rst_n(rst_n),.I_video_vsync(1'b0),.I_video_hsync(1'b0),
        .I_video_de(de),.I_video_user(sof),.I_video_last(last),.I_video_rd_data(READ_LATENCY==2 ? d2:raw),
        .I_debug_status(4'd0),.I_meas_upd(1'b0),.I_span(16'd0),.I_hole(16'd0),.I_meas_valid(1'b0),
        .I_meas_status(3'd0),.I_center_x(11'd0),.I_center_y(11'd0),.I_hole_x(11'd0),.I_hole_y(11'd0),
        .I_thresh_upd(1'b0),.I_thresh(8'd128),.I_bbox_upd(1'b0),.I_bbox_valid(1'b0),.I_bbox_moving(1'b0),
        .I_bbox_cnt(24'd0),.I_bbox_type(3'd0),.I_bbox_color(3'd0),.I_roi_upd(1'b0),.I_roi_valid(1'b0),
        .I_display_mode(3'd7),.I_camera_status({1'b0,16'h1142,12'h112}),.I_camera_status_upd(upd),
        .I_ae_diagnostics({8'd152,1'b1,1'b1,1'b1,5'd16,8'd3,1'b0}),.I_ae_diagnostics_upd(upd),
        .I_color_reference(32'd0),.I_color_reference_upd(1'b0),.I_color_diag(128'd0),.I_wb_diag(128'd0),.I_wb_diag_upd(1'b0),
        .I_targets(224'd0),.I_target_count(3'd0),.I_target_overflow(1'b0),
        .I_batch_counts_bcd(48'h001003005008),.I_batch_total_counts_bcd(48'h003004007009),
        .I_batch_targets_bcd(48'h002004006010),.I_batch_filter_type(3'd1),.I_batch_done(batch_done),
        .I_batch_overrun(batch_ng),.I_batch_overrun_mask(ng_mask),.I_batch_wait_clear(wait_clear),
        .I_enhance_strength(2'd2),.I_enhance_noise(4'd4),
        .I_enhance_compare(compare),
        .I_menu_open(menu),.I_menu_index(selection),.I_menu_preview_mode(3'd7),.I_menu_motor_level(motor),
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
