ji1109-shuai/fpgashare/(commit log)

2026-10-18 初始化工程：多目标识别与白平衡诊断
    [.m_params_MCU.txt, .m_params_PLL.txt, .m_params_blk_mem_gen_awb_delay_signal.txt, .m_params_blk_mem_gen_demosaic.txt, .m_params_blk_mem_gen_zhenghe.txt, .m_params_ddr2.txt, .m_params_w128_d512_fifo.txt, .m_params_w155_d512_fifo.txt]
2026-10-18 docs: 补齐工程交接、历史资料、仿真与协作指南
2026-10-19 fix: 自动中性取样白平衡并保持有效补偿（待上板验证）
2026-10-19 docs: 记录自动白平衡上板通过并保存颜色优化起点
2026-10-19 fix: HSV色相区分红与黄铜并改善黑色反光识别（待上板）
2026-10-22 test: 覆盖垫圈反光缺口和孔内阴影
2026-10-24 feat: 增加识别批次延迟OSD及功能仿真（待上板）
2026-11-03 feat: publish current full-system source and supporting materials
    Include current AE, industrial enhancement, batch control, motor/FPS, buzzer, tests, tools and mechanical sources. Preserve third-party notices and exclude build caches.
    [.m_params_MCU.txt, .m_params_PLL.txt, .m_params_blk_mem_gen_awb_delay_signal.txt, .m_params_blk_mem_gen_demosaic.txt, .m_params_blk_mem_gen_zhenghe.txt, .m_params_ddr2.txt, .m_params_w128_d512_fifo.txt, .m_params_w155_d512_fifo.txt]
